JDanison/ENGT-480---Senior-Capstone/Project Notes/Danison - Semester 2 Project Notes 07.pptx

## Wabash Capstone Project Notes 07

By: John Danison

## What Did I Say I Would Do This Week?

Continue to support lab testing as requested.
Continue to develop data offloading software.

## What I Have Done Over The Past Week

Performed lab testing on Kingpin assembly and on steel cutout.
Added features to Wabash data offloading software.
Attended meetings and class.
Updated schematics and recorded Gate 5.5 presentation.

## Lab Testing – Dudley UTM Machine

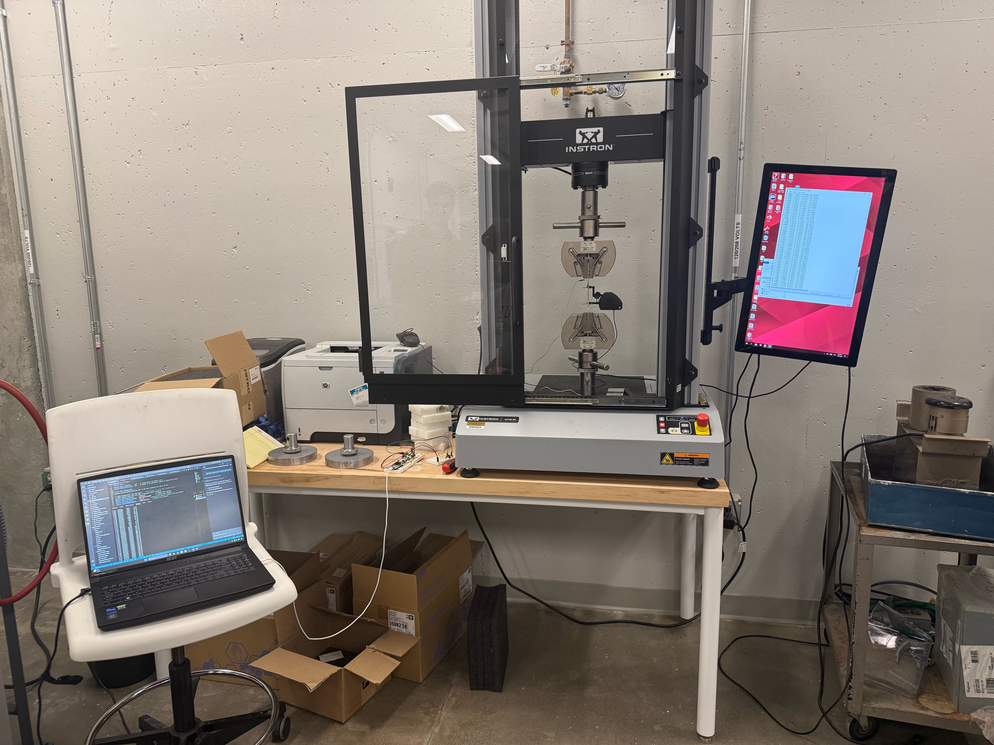
[picture p1: figure]
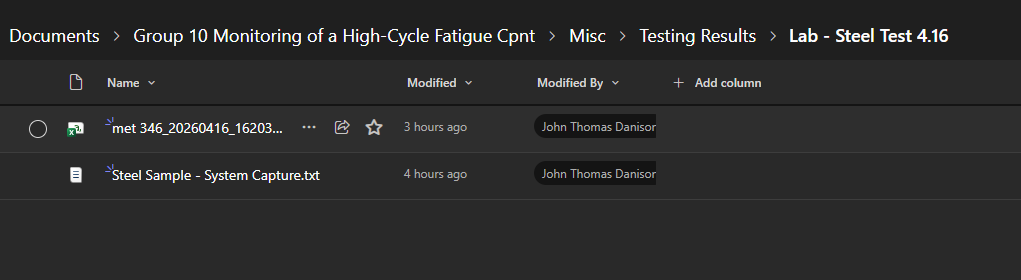
[picture p2: figure]

## Wabash Software Updates

## Slide 6

Wabash Software Updates

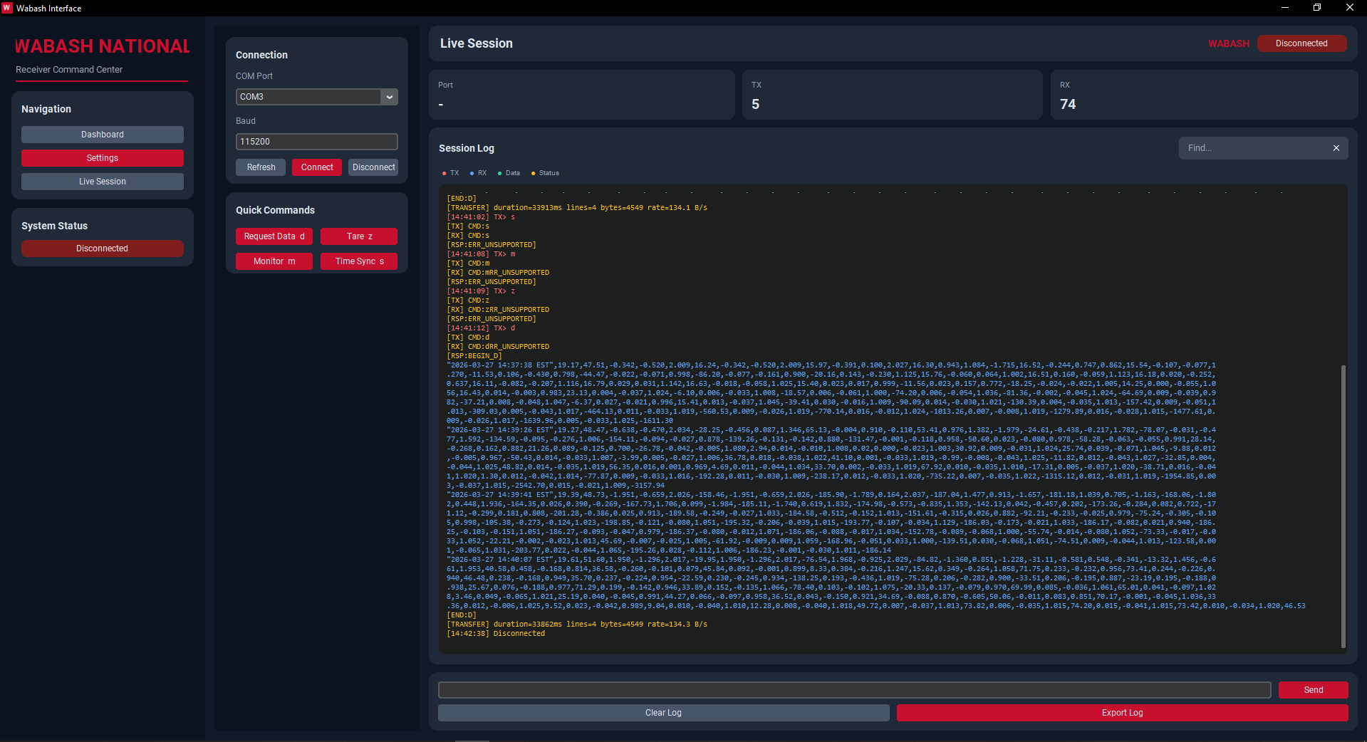
[picture p3: figure]

Initial Presentation: 3/27

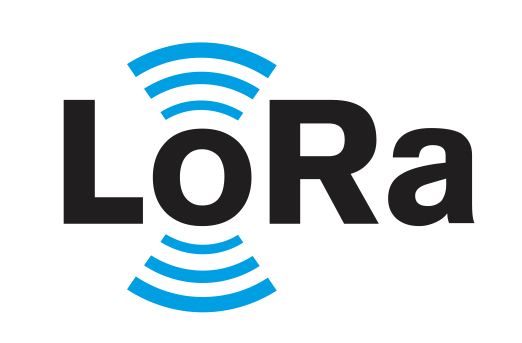
[picture p4: figure]
Lora - Key Features and Advantage |
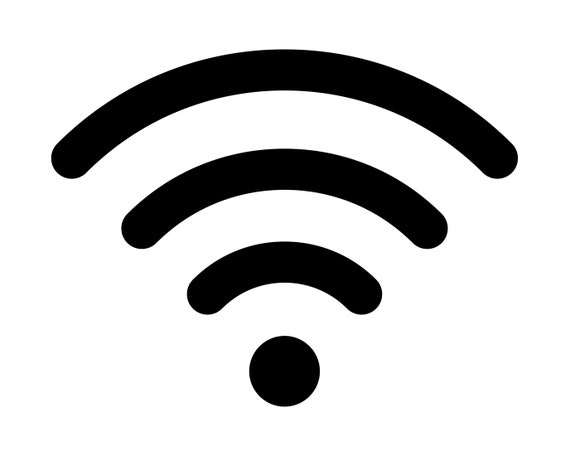
[picture p5: figure]
WiFi SVG, PNG - Wifi Clipart, Wifi Signal Svg, Wireless Internet Svg, WiFi Icon, Wi-Fi Svg, Cut File For Cricut & Silhouette
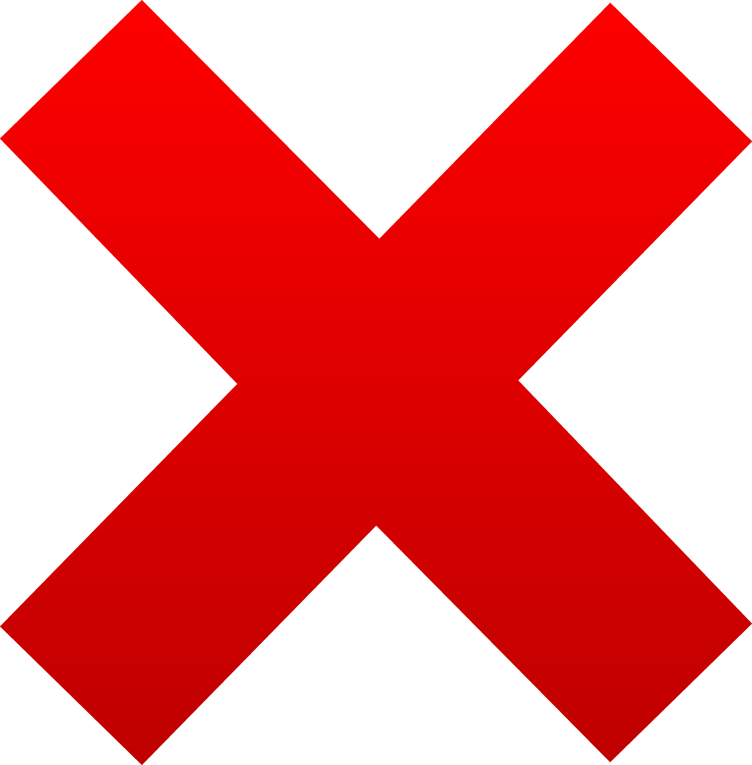
[picture p6: figure]
Simple Red X Mark Free Clip Art Clipart - Red X Mark Transparent Background - (6015x6124) Png Clipart Download

## Slide 7

Wabash Software Updates

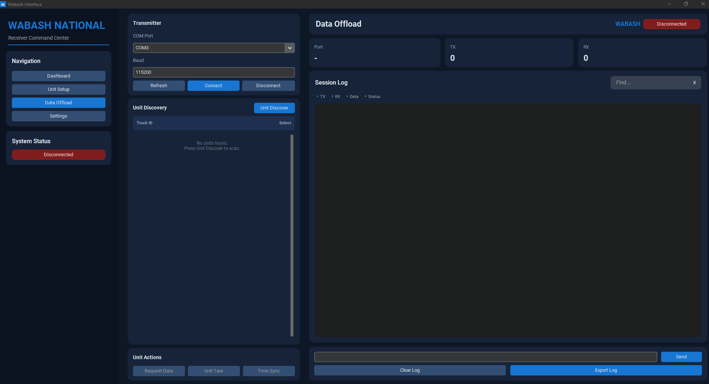
[picture p7: figure]

Presented: 4/10

## Slide 8

Wabash Software Updates

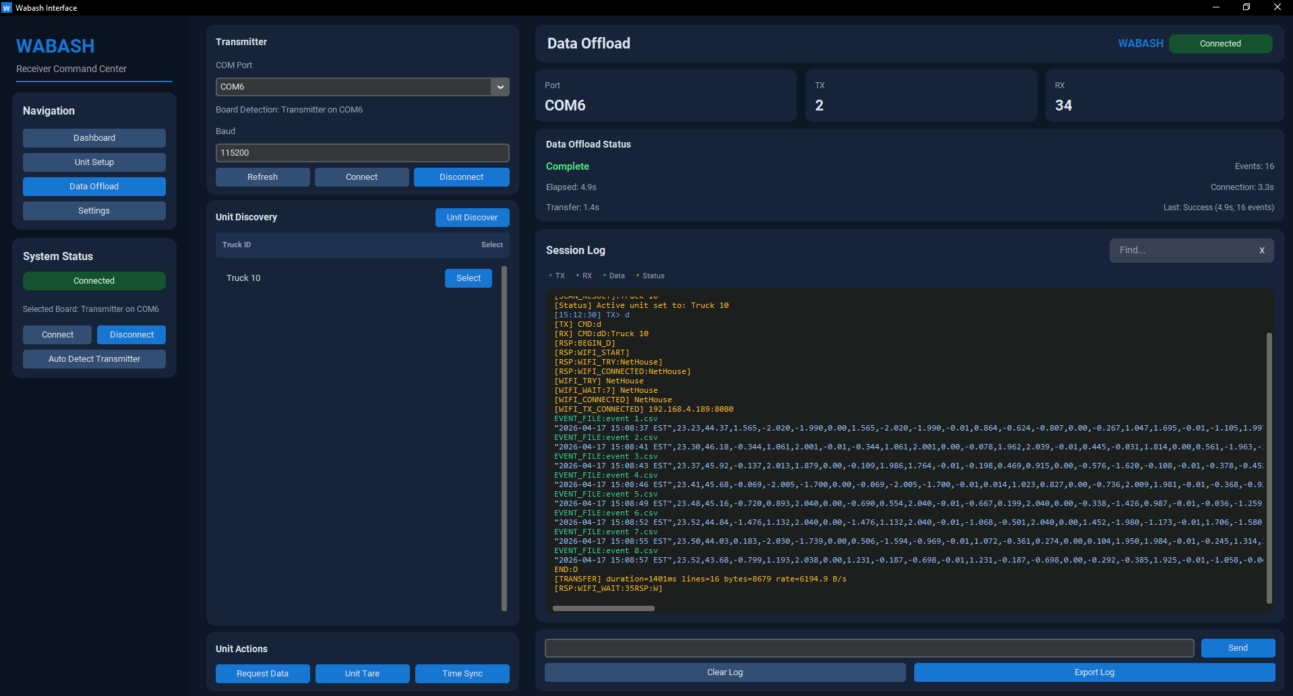
[picture p8: figure]

Current Version

## Slide 9

Wabash Software Updates

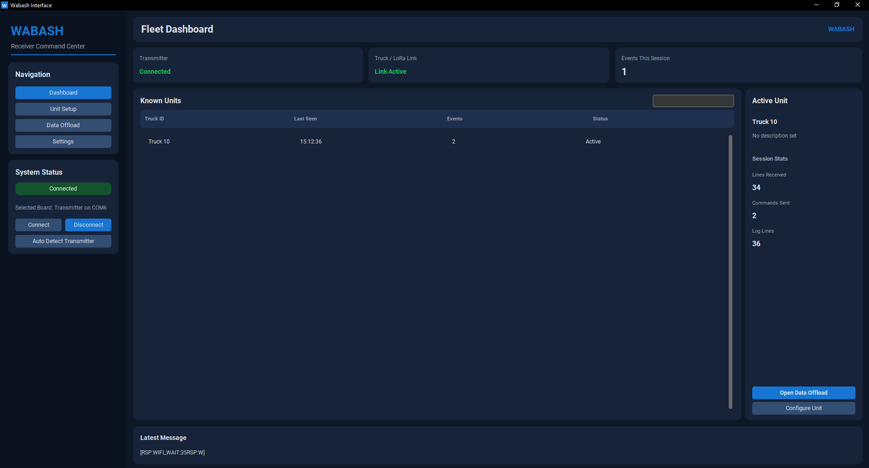
[picture p9: figure]

## Slide 10

Wabash Software Updates

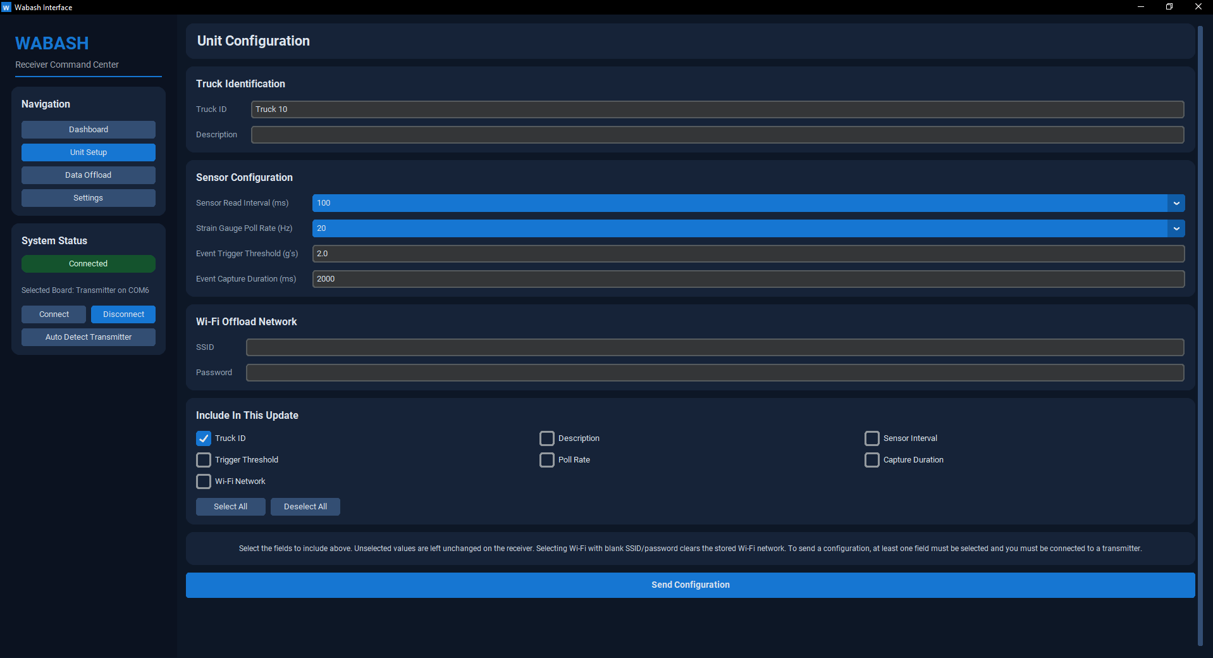
[picture p10: figure]

## Slide 11

Wabash Software Updates

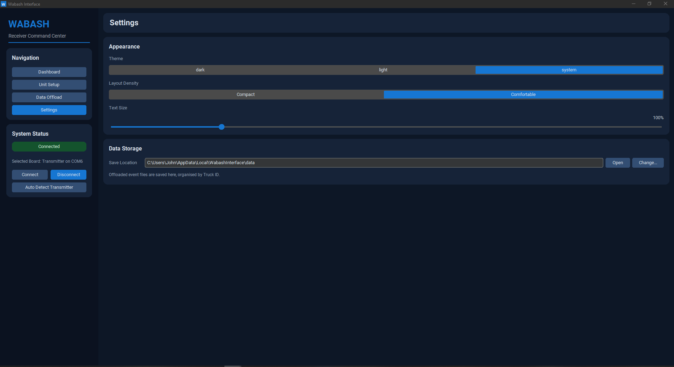
[picture p11: figure]

## Slide 12

Wabash Software Updates

SD Card Setup:

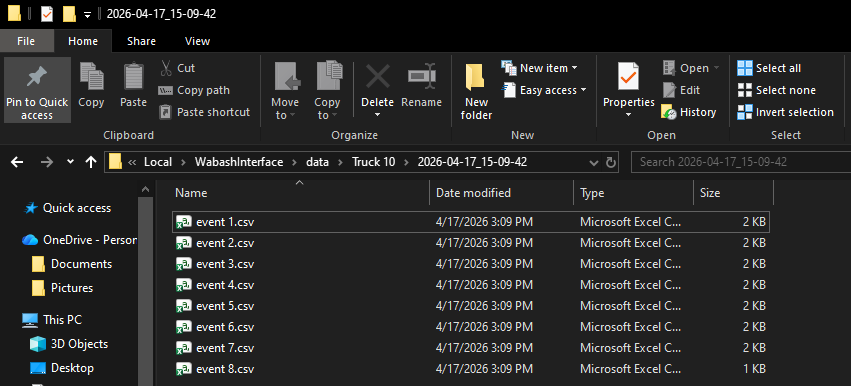
[picture p12: figure]

App Data Local Storage

## Slide 13

Wabash Software Updates

Demo Video can be found at the end of the Gate 5.5 presentation submission.
The video was giving me issues here unfortunately.

## Slide 14

Schematic Update – Added Capacitors

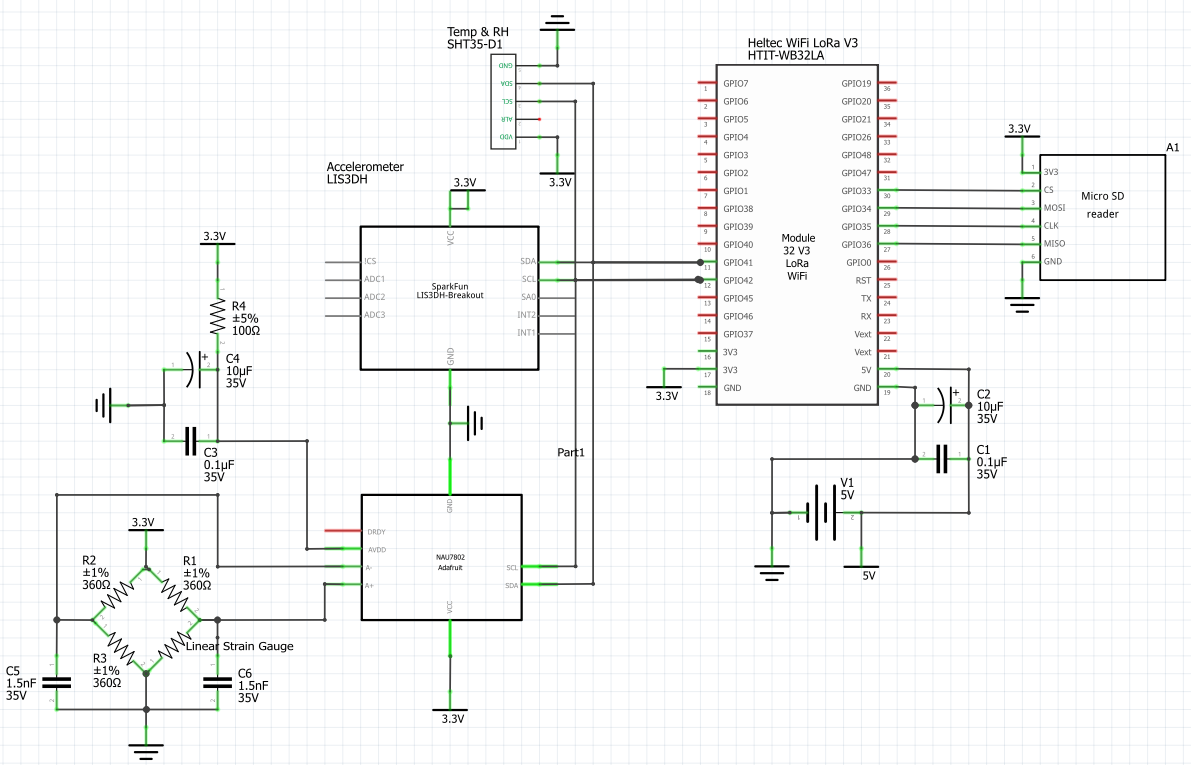
[picture p13: figure]

## Did I Do What I Say I Would Do?

I feel that I accomplished everything that I said I would do over these past couple weeks.
The data offloading software is well under development is still going well.
I attended all lectures, labs, and meetings w/ the client.

## Plans For Upcoming Weeks

High Level
By EOW:
Continue to develop data offloading software.
Continue to show up to class.
Continue to support lab testing as requested by the team.
Continue to add client feature requests in data offloading software.
