JDanison/ENGT-480---Senior-Capstone/Project Notes/Danison - Project Notes 01.pptx

## Wabash Capstone Project Notes 01

By: John Danison

## What Have I Done This Week

- Met In Person w/ Client
  - Reviewed & Gained Insight Into Project
- Reviewed What Current State-Of-The-Art Is
  - Researched patents, products, & more.
  - Wrote 2.2 in CW16
- Started Brainstorming System Sensors
- Started Brainstorming System Power

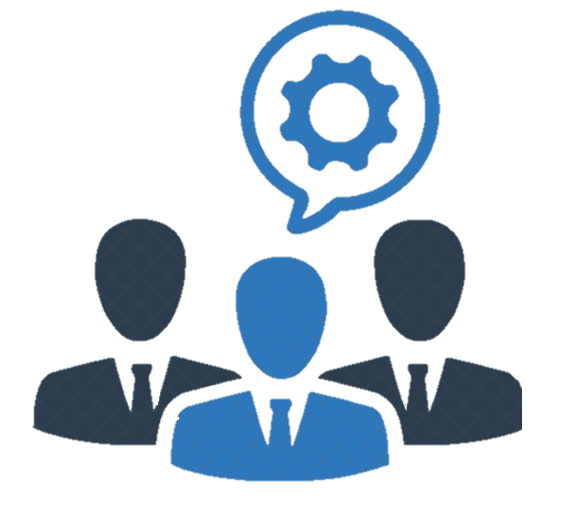
[picture p23: figure]
Technical Team Icon - Technical Team Icon - Free Transparent PNG Clipart Images Download
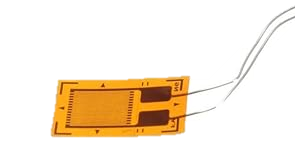
[picture p24: figure]
DAOKI 10Pcs BF350-3AA BF350 350 ohm High-Precision Pressure Resistance Strain Gauge
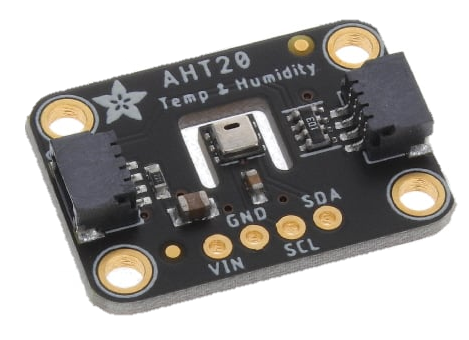
[picture p25: figure]
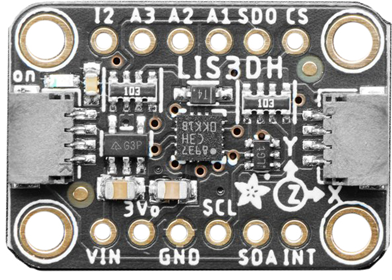
[picture p26: figure]

## Did I Do What I Say I Would Do?

Yes, I feel that I met my promises this past week. There is nothing outstanding where I am holding my group back from making progress.
I have attended every class so far.

## Plans For Upcoming Week

Continue To:
Research Existing Solutions & Define SOTA.
Brainstorm Sensors, Power Systems, & Data Acquisition Strategies
Communicate with Team Members
By EOW, Have Finalized Scope Of Work & Timeline
