JDanison/ENGT-480---Senior-Capstone/Project Notes/Danison - Project Notes 02.pptx

## Wabash Capstone Project Notes 02

By: John Danison

## What Have I Done This Week

- Met Online With Client
  - Gave updates into current SOTA
  - Summarized research conducted
- Brainstormed & Researched Microcontrollers
  - Opt 1 - Heltec WiFi LoRa v3
  - Opt 2 - ESP32-C3
  - Opt 3 - nRF52840
- Wrote Technical Report in CW 18

Technical Team Icon - Technical Team Icon - Free Transparent PNG Clipart Images Download
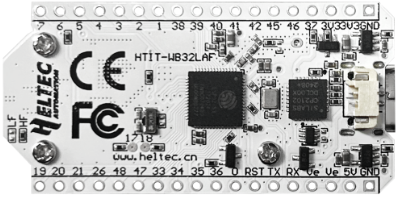
[picture p27: figure]
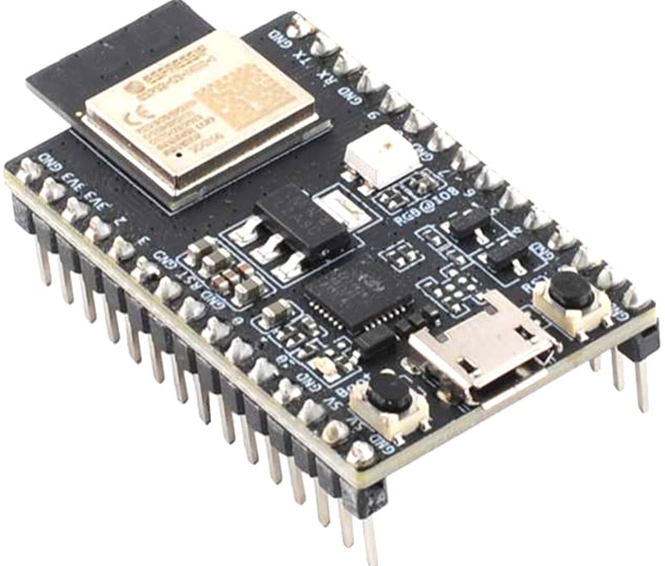
[picture p28: figure]
Amazon.com: ESP32-C3-DevKitM-1 ESP32 C3 Development Board ESP32-C3-MINI-1 WiFi+BT BLE Module ESP32-C3FN4 Core 4MB Flash for Arduino : Electronics
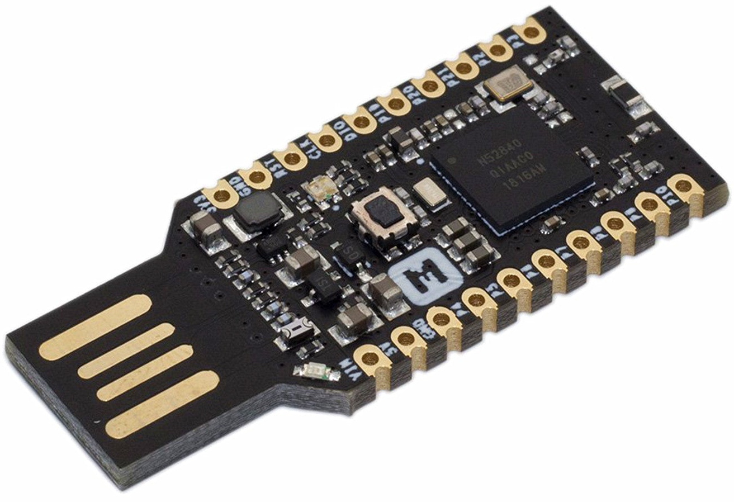
[picture p29: figure]

## Did I Do What I Say I Would Do?

Yes, I feel that I met my promises this past week. There is nothing outstanding where I am holding my group back from making progress.
I have attended every class so far. I lead the team in technical solution brainstorming.

## Plans For Upcoming Week

Continue To:
Continue to Brainstorm Sensors, Power Systems, & Data Acquisition Strategies
Communicate with Team Members
By EOW:
Work on Gate Report
Continue To Research / Become Expert On Trailer Couplers & Kingpins
