JDanison/ENGT-480---Senior-Capstone/Project Notes/Danison - Project Notes 03.pptx

## Wabash Capstone Project Notes 03

By: John Danison

## What Have I Done This Week

- Researched further into Kingpin & Couplers
- Scheduled a Time to Meet For GR1.5
- Wrote Gate Report 1

Technical Team Icon - Technical Team Icon - Free Transparent PNG Clipart Images Download
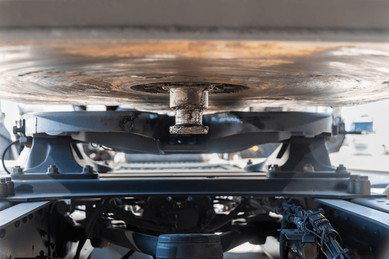
[picture p30: figure]
Close-up Trailer Kingpin Fifth Wheel Coupling Stock Photo 2614683175 | Shutterstock
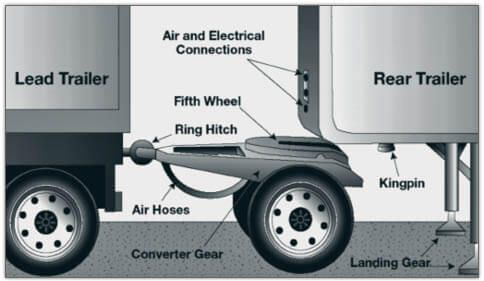
[picture p31: figure]
Coupling/Uncoupling

## Did I Do What I Say I Would Do?

Yes, I feel that I met my promises this past week. There is nothing outstanding where I am holding my group back from making progress.
I have attended every class so far. I continue to lead the EE & DAQ of this project.

## Plans For Upcoming Week

Continue To:
Refine Sensors, Power Systems, & Data Acquisition Strategies
Communicate with Team Members
By EOW:
Present GR1.5
Acquire More Information From Wabash
