JDanison/ENGT-480---Senior-Capstone/Project Notes/Danison - Project Notes 05.pptx

## Wabash Capstone Project Notes 05

By: John Danison

## What Have I Done This Week

- Researched Potential Sensor Options
- Selected Sensors, Microcontroller, & Storage
- Started Drafting Data Acquisition Solutions
  - Duration (Burst or Constant)
  - How Data Is Stored & How Often

Technical Team Icon - Technical Team Icon - Free Transparent PNG Clipart Images Download

## Did I Do What I Say I Would Do?

As usual, I feel that I met my promises this past week.
There is nothing outstanding where I am holding my group back from making progress.
I have attended every class so far. I continue to lead the EE & DAQ of this project.

## Plans For Upcoming Week

Continue To:
Refine Data Acquisition Strategy | Specifically How Data Will Be Formatted
Communicate with Team Members
By EOW:
Have Sensors Picked & Documentation For Reasons Complete
