JDanison/ENGT-480---Senior-Capstone/Project Notes/Danison - Semester 2 Project Notes 06.pdf

# Wabash Capstone Project Notes 06

## By: John Danison

# What Did I Say I Would Do This Week?

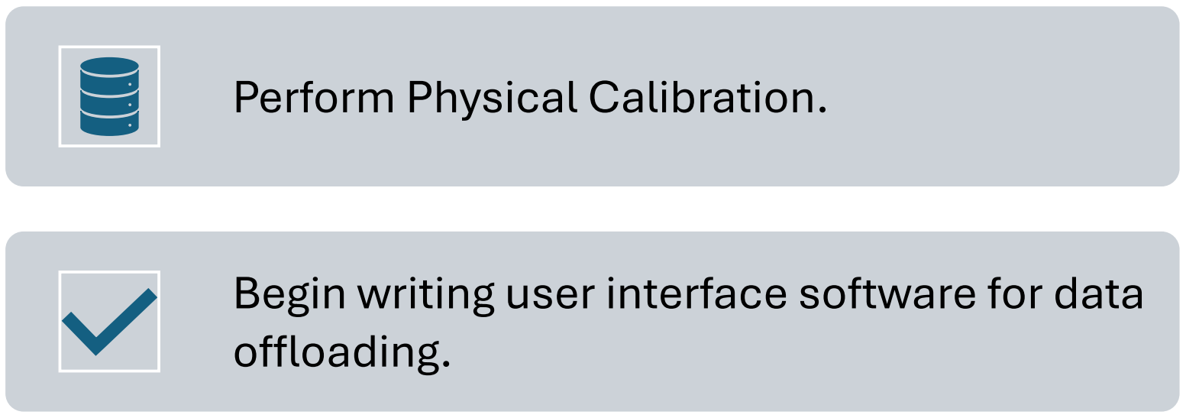
[picture p43: figure]
Perform Physical Calibration.; offloading.

## Begin writing user interface software for data

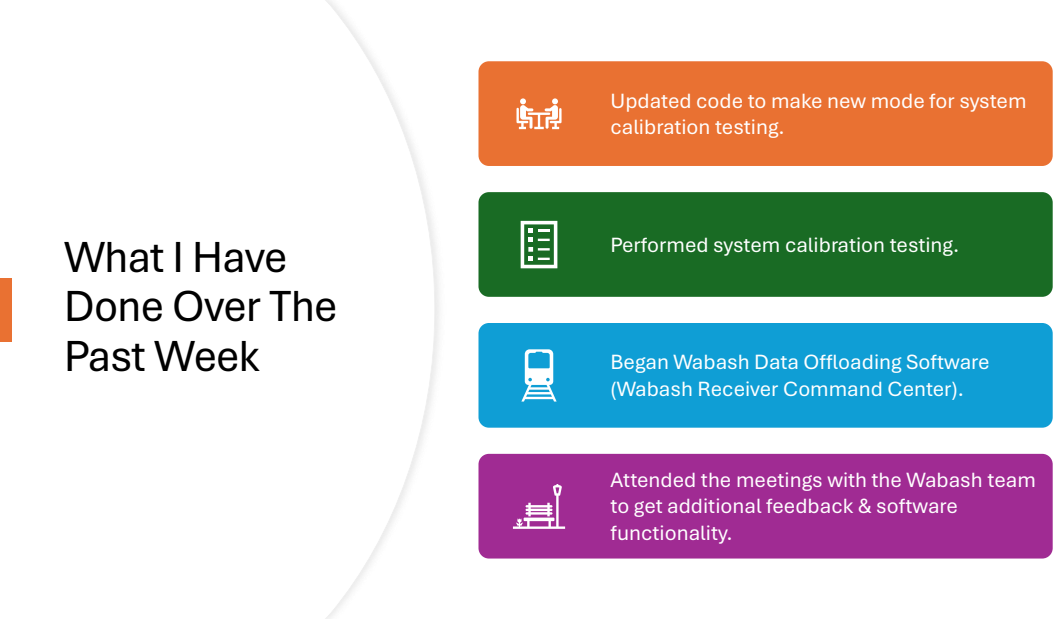
[picture p44: page 3]

Updated code to make new mode for system
calibration testing.

What I Have
Done Over The
Past Week

Performed system calibration testing.

Began Wabash Data Offloading Software
(Wabash Receiver Command Center).

Attended the meetings with the Wabash team
to get additional feedback & software
functionality.

# Updated Code w/ New Mode

4/10/2026 4

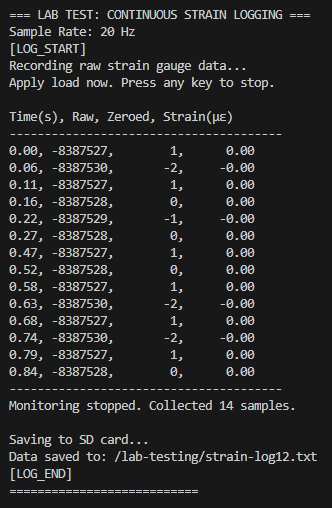
[picture p45: figure]

I made another line option “L” to allow for continuous data capture and then to write this to the SD card.

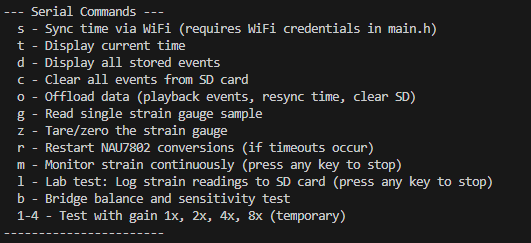
[picture p46: figure]

# Calibration Testing - Setup

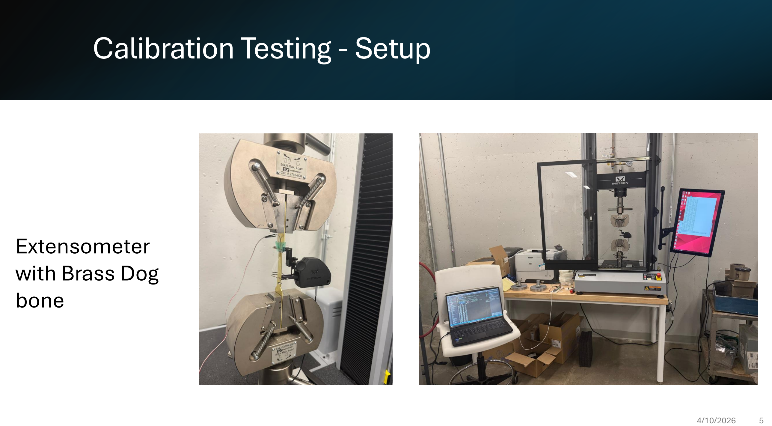
[picture p47: page 5]

## Extensometer with Brass Dog bone

# Calibration Testing - Results

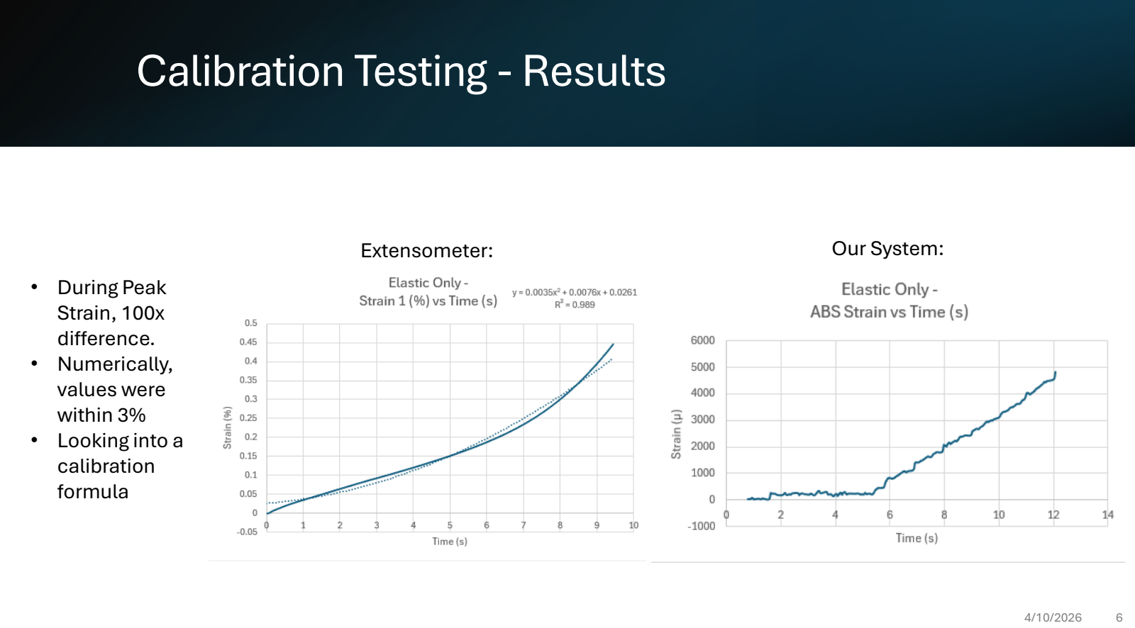
[picture p48: page 6]

Extensometer: | Our System:
- During Peak
Strain, 100x
difference.
- Numerically,
values were
within 3%
- Looking into a
calibration
formula

# Wabash Data Offloading Software

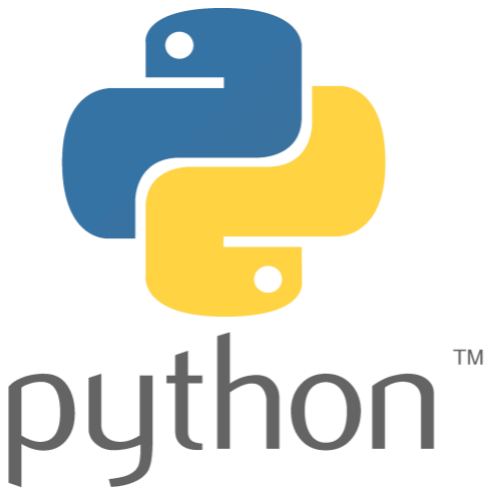
[picture p49: figure]

- customtkinter (main desktop UI framework)
- pyserial (serial communication with hardware)
- pillow (image handling for the UI/assets)
- pyinstaller (packaging the app into an executable)
- setuptools (build/packaging backend)
- wheel (build artifact support)

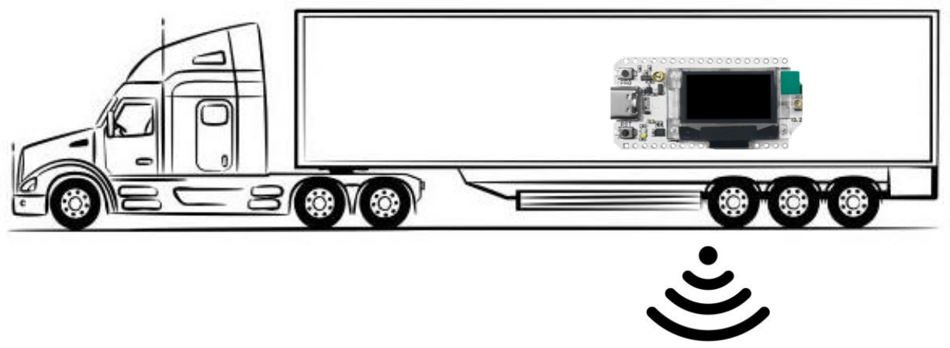
[picture p50: figure]
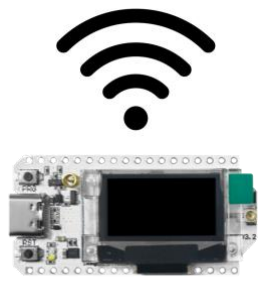
[picture p51: figure]
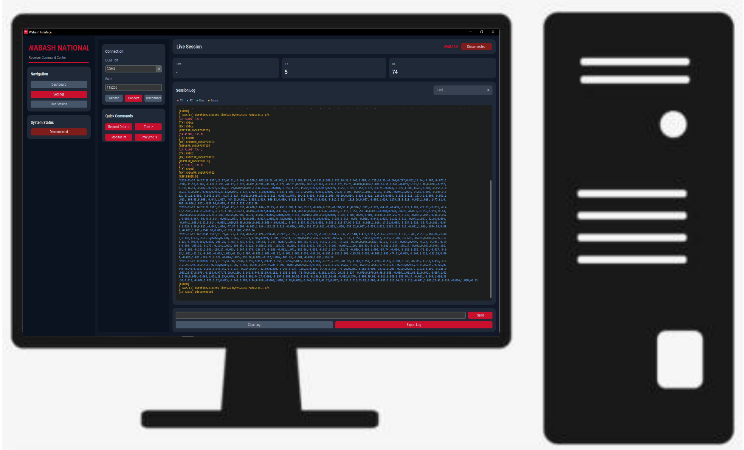
[picture p52: figure]

# Wabash Data Offloading Software - Old

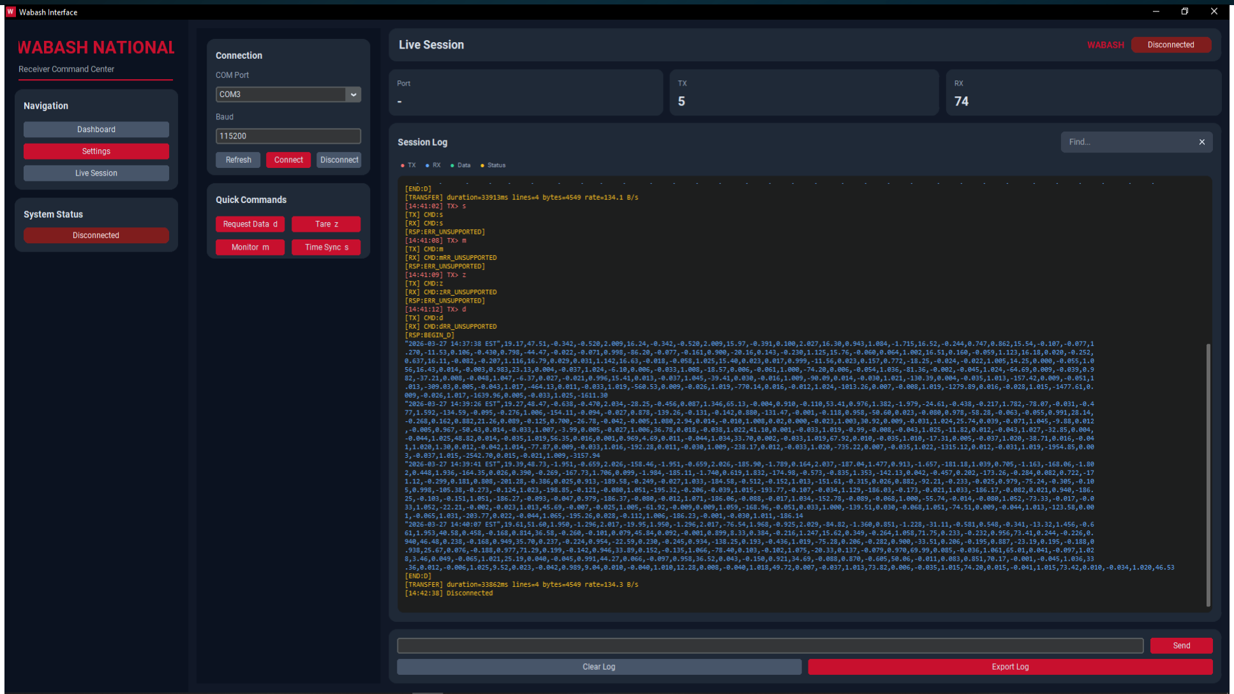
[picture p53: figure]

# Wabash Data Offloading Software - Current

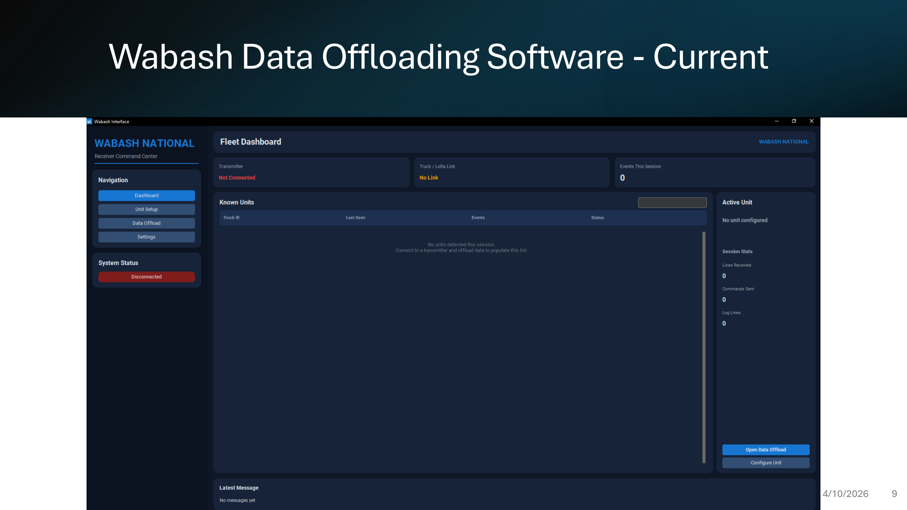
[picture p54: page 9]

# Wabash Data Offloading Software - Current

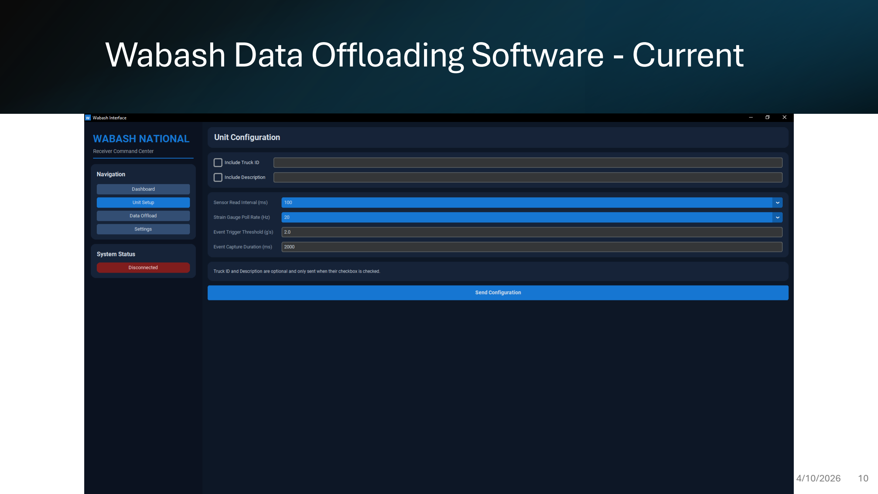
[picture p55: page 10]

# Wabash Data Offloading Software - Current

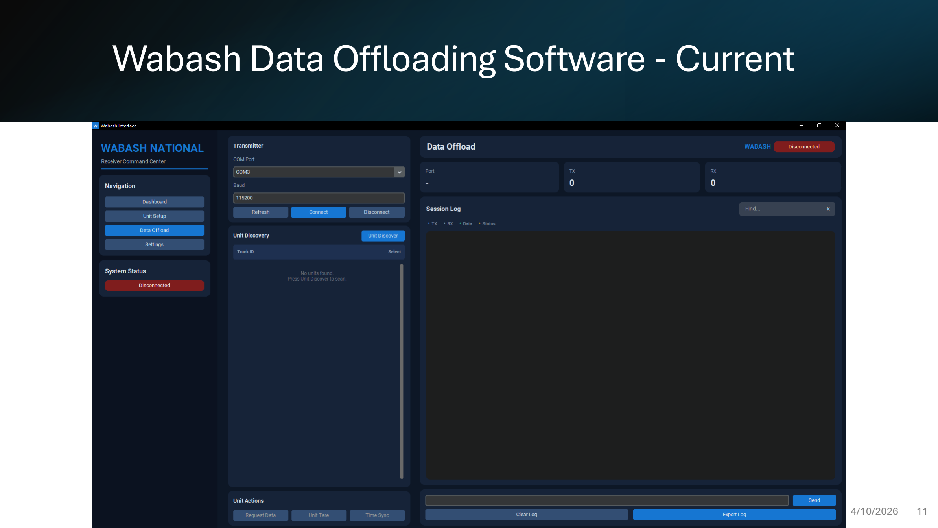
[picture p56: page 11]

# Wabash Data Offloading Software - Current

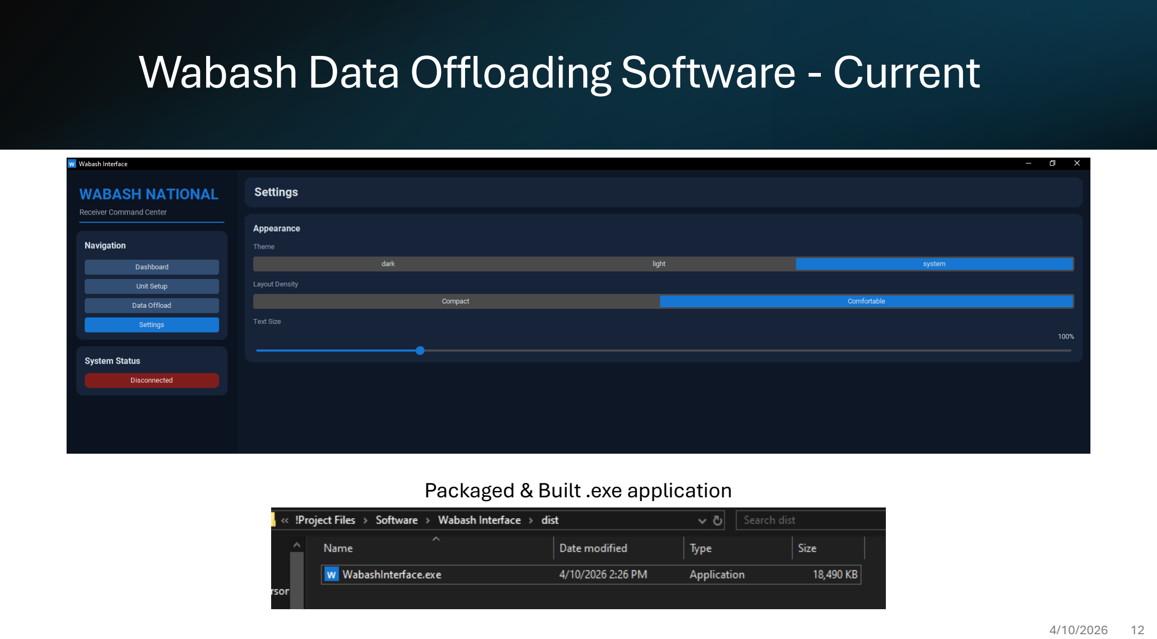
[picture p57: page 12]

Packaged & Built .exe application

# Did I Do What I Say I Would Do?

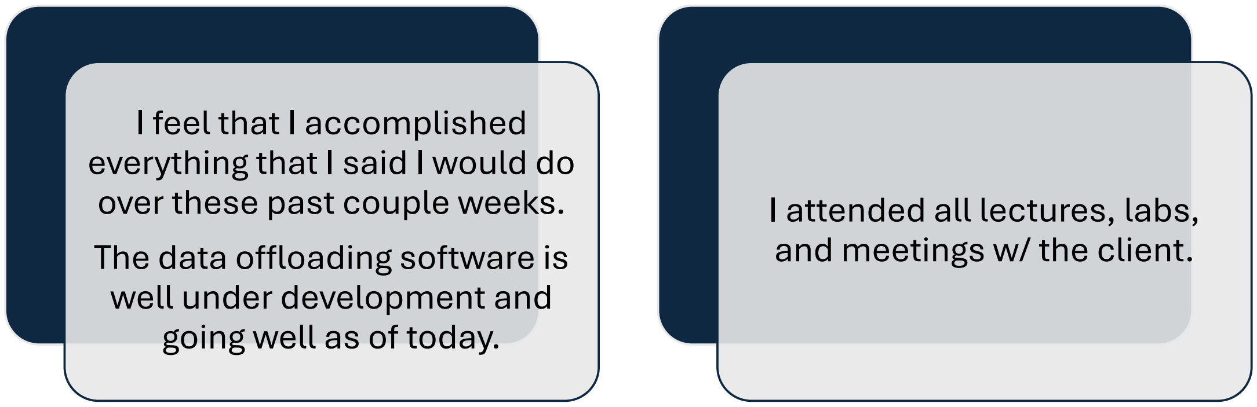
[picture p58: figure]
I feel that I accomplished everything that I said I would do over these past couple weeks. The data offloading software is well under development and going well as of today.; I attended all lectures, labs, and meetings w/ the client.

# Plans For Upcoming Weeks

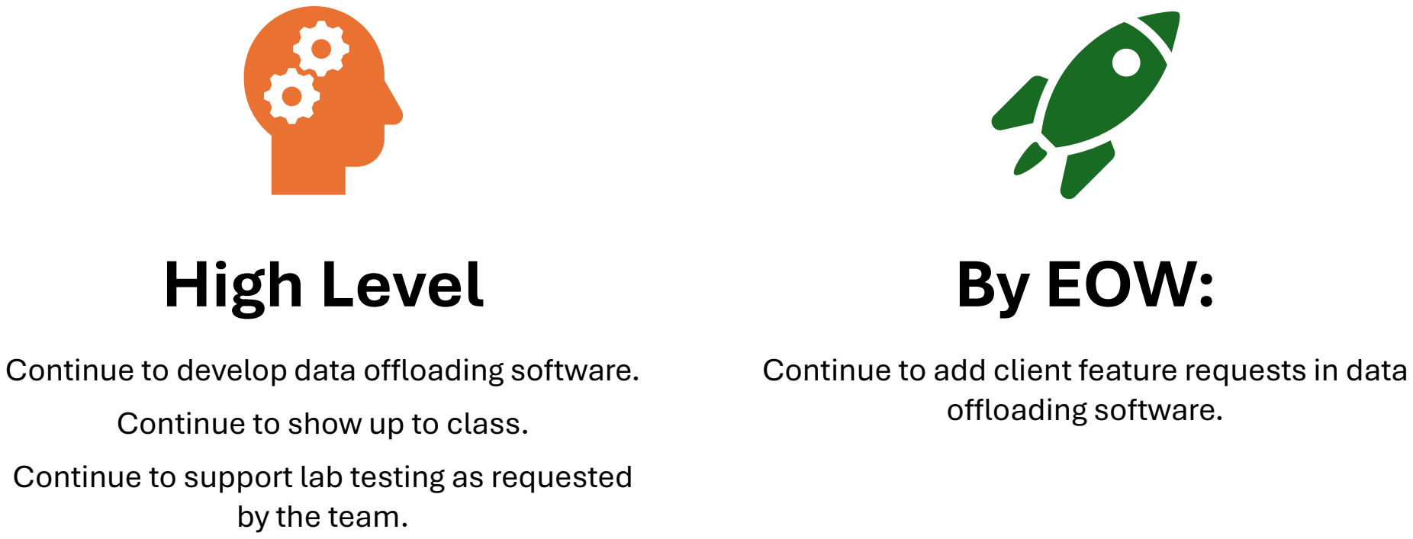
[picture p59: figure]
High Level; Continue to show up to class.; by the team.; By EOW:; offloading software.

Continue to develop data offloading software.

Continue to support lab testing as requested

Continue to add client feature requests in data
