JDanison/ENGT-480---Senior-Capstone/Project Notes/Danison - Semester 2 Project Notes 05.pdf

# Wabash Capstone Project Notes 05

## By: John Danison

# What Did I Say I Would Do This Week?

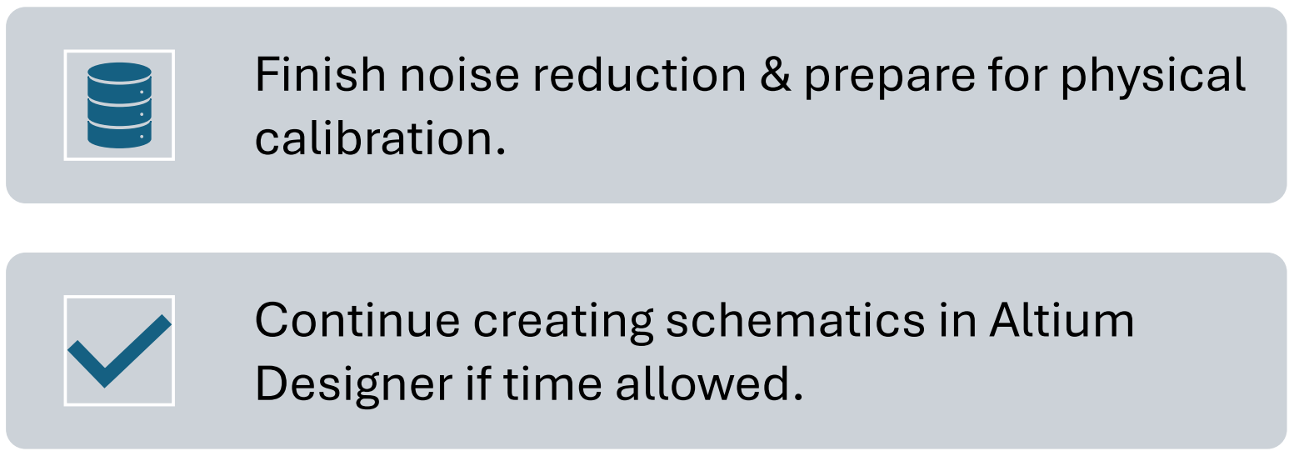
[picture p60: figure]
calibration.; Continue creating schematics in Altium Designer if time allowed.

## Finish noise reduction & prepare for physical

# What I Have

# Done Over The Past Week

Finished the noise reduction for the time being. I am as prepared as I can be for the physical calibration testing.

Began attempting to integrate new temperature sensor into system.

Produced new system demonstration for the Gate Report 4.5

Attended the meeting with the Wabash team. Starting planning and mapping out wireless data transfer process. Using Wabash feedback for their wishes.

# Video Demo

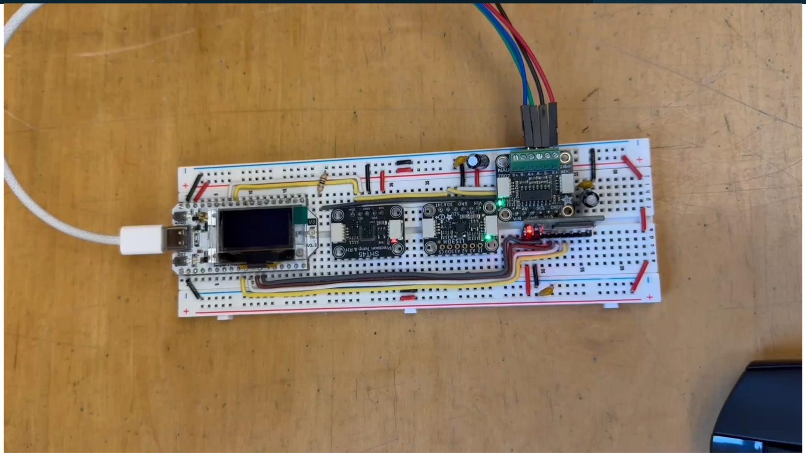
[picture p61: figure]

# Did I Do What I Say I Would Do?

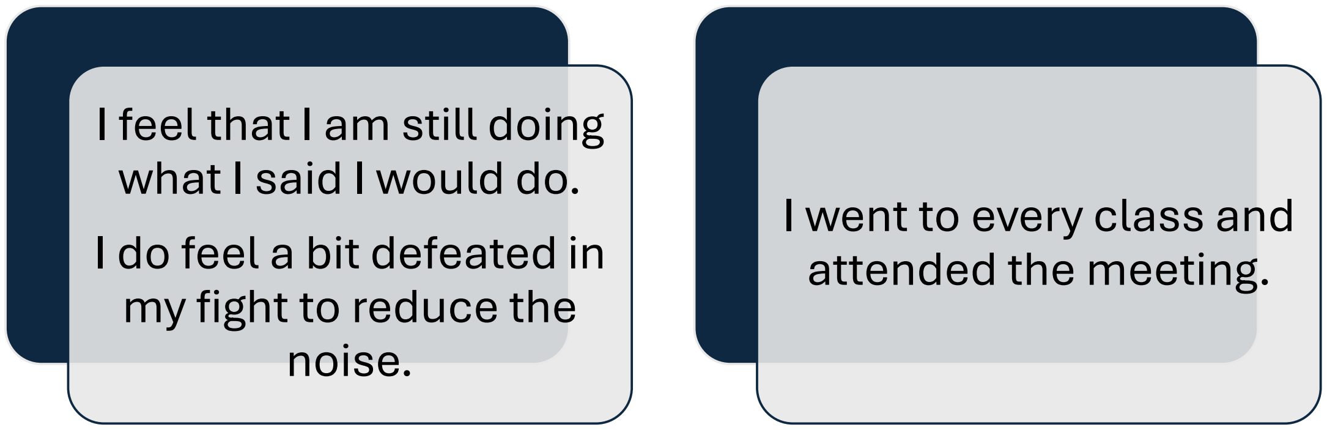
[picture p62: figure]
I feel that I am still doing what I said I would do. I do feel a bit defeated in my fight to reduce the noise.; I went to every class and attended the meeting.

# Plans For Upcoming Weeks

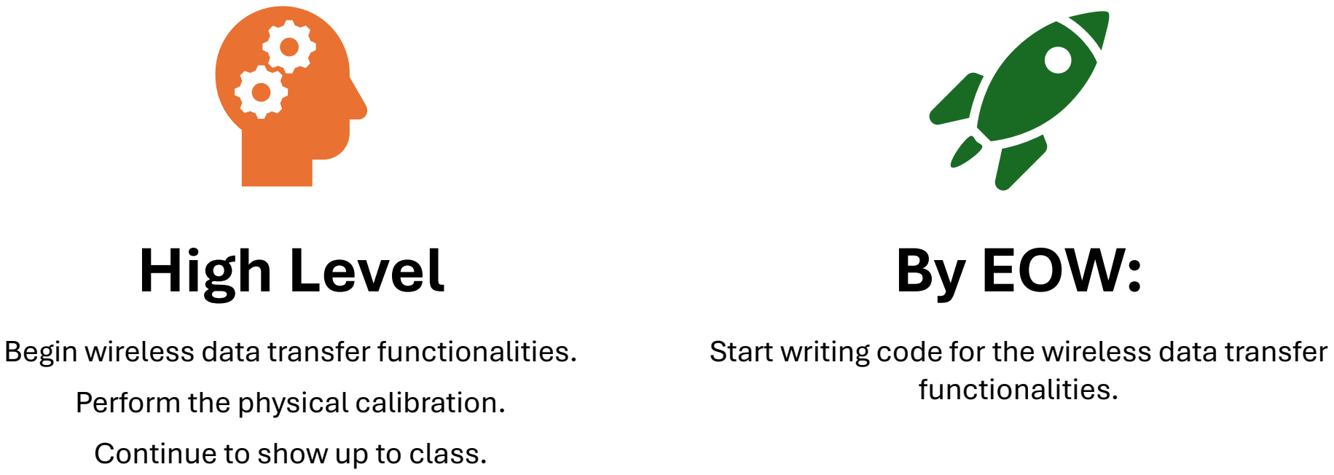
[picture p63: figure]
High Level; Begin wireless data transfer functionalities. Perform the physical calibration. Continue to show up to class.; By EOW:; functionalities.

Start writing code for the wireless data transfer
