JDanison/ENGT-480---Senior-Capstone/Project Notes/Danison - Project Notes 04.pdf

# Wabash Capstone Project Notes 04

By: John Danison

## What Have I Done This Week

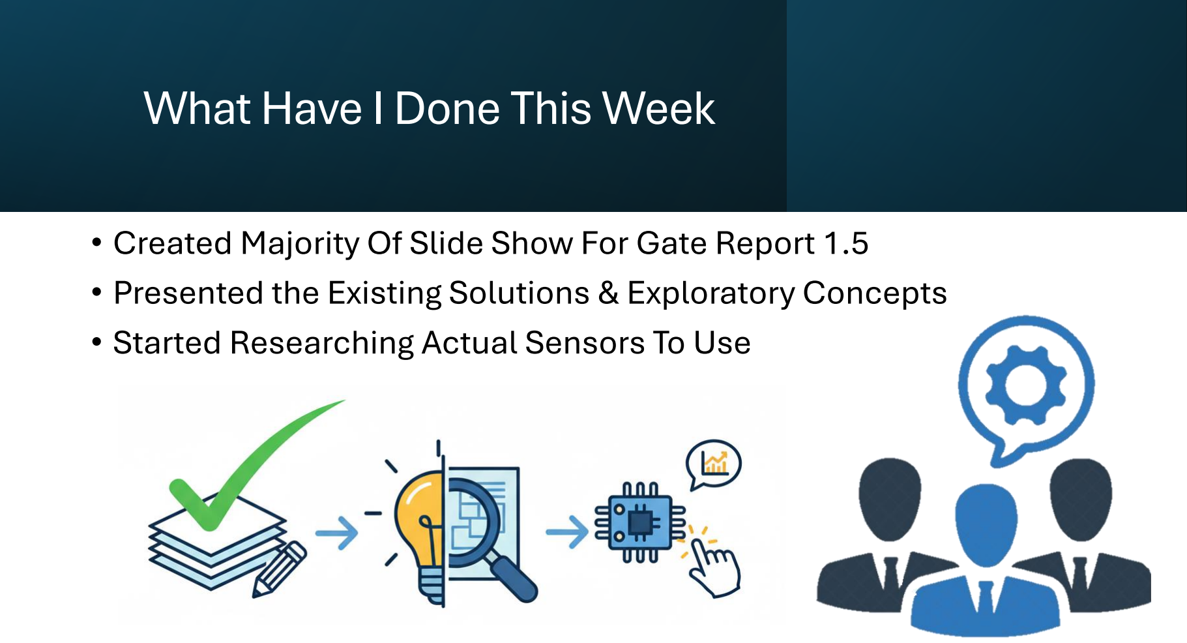
[picture p74: page 2]

- Created Majority Of Slide Show For Gate Report 1.5
- Presented the Existing Solutions & Exploratory Concepts
- Started Researching Actual Sensors To Use

## Did I Do What I Say I Would Do?

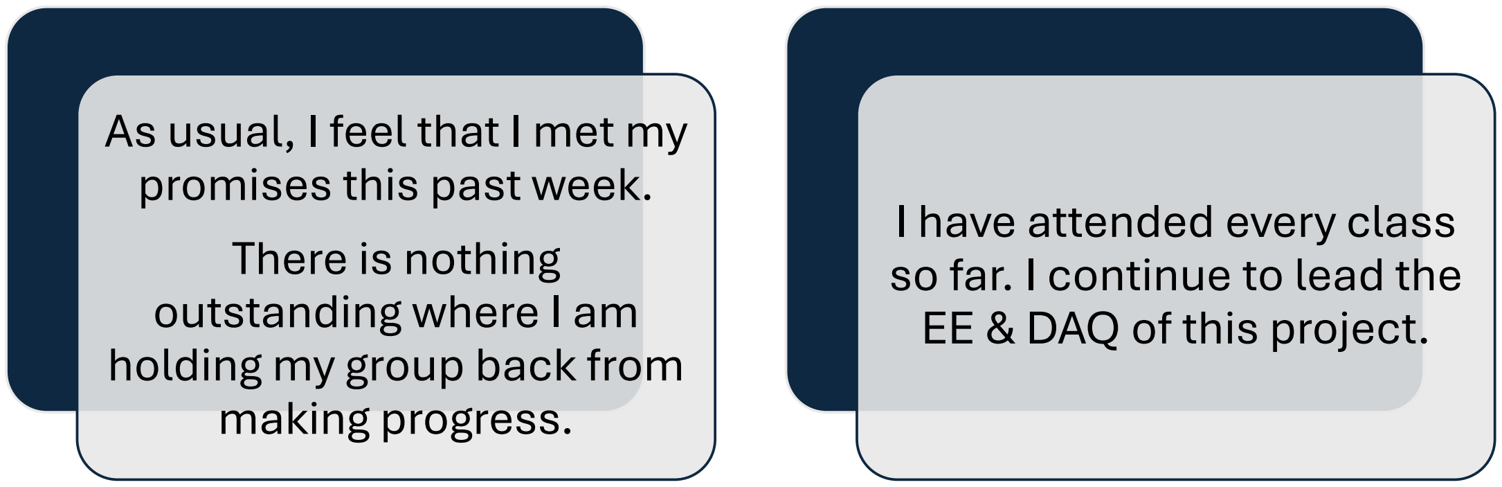
[picture p75: figure]
As usual, I feel that I met my promises this past week. There is nothing outstanding where I am holding my group back from making progress.; I have attended every class so far. I continue to lead the EE & DAQ of this project.

## Plans For Upcoming Week

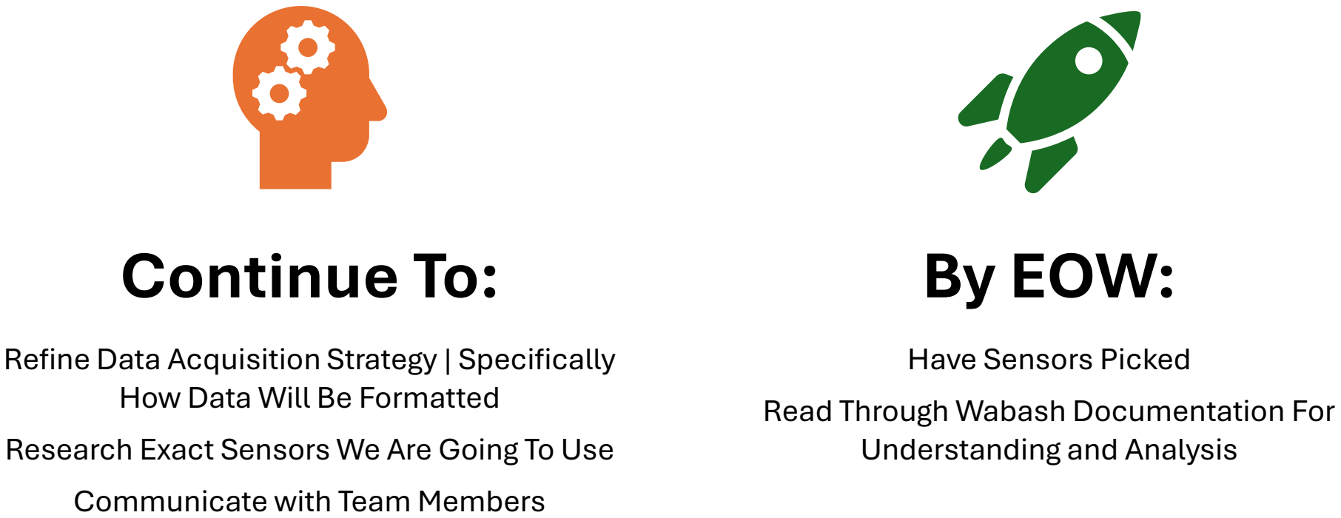
[picture p76: figure]
Continue To:; How Data Will Be Formatted; Communicate with Team Members; By EOW:; Have Sensors Picked Read Through Wabash Documentation For Understanding and Analysis

Refine Data Acquisition Strategy | Specifically

Research Exact Sensors We Are Going To Use
