JDanison/ENGT-480---Senior-Capstone/Project Notes/Danison - Semester 2 Project Notes 08.pptx

## Wabash Capstone Project Notes 08

By: John Danison

## What Did I Say I Would Do This Week?

Continue to support lab testing as requested.
Continue to develop data offloading software.

## What I Have Done Over The Past Week

Performed lab testing on Kingpin assembly.
Added features to Wabash data offloading software.
Attended meetings and class.
Contributed to Capstone Poster.

## Slide 4

Wabash Lab Testing

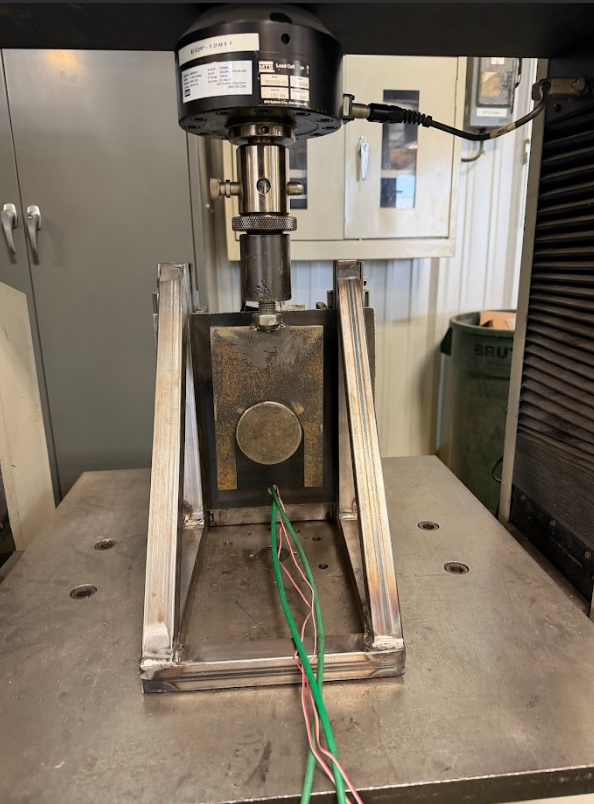
[picture p77: figure]

Went to Wabash:
- Attached system to their rig
- Gathered data
- Troubleshot issues
- Showed offloading software

## Slide 5

Wabash Software Updates

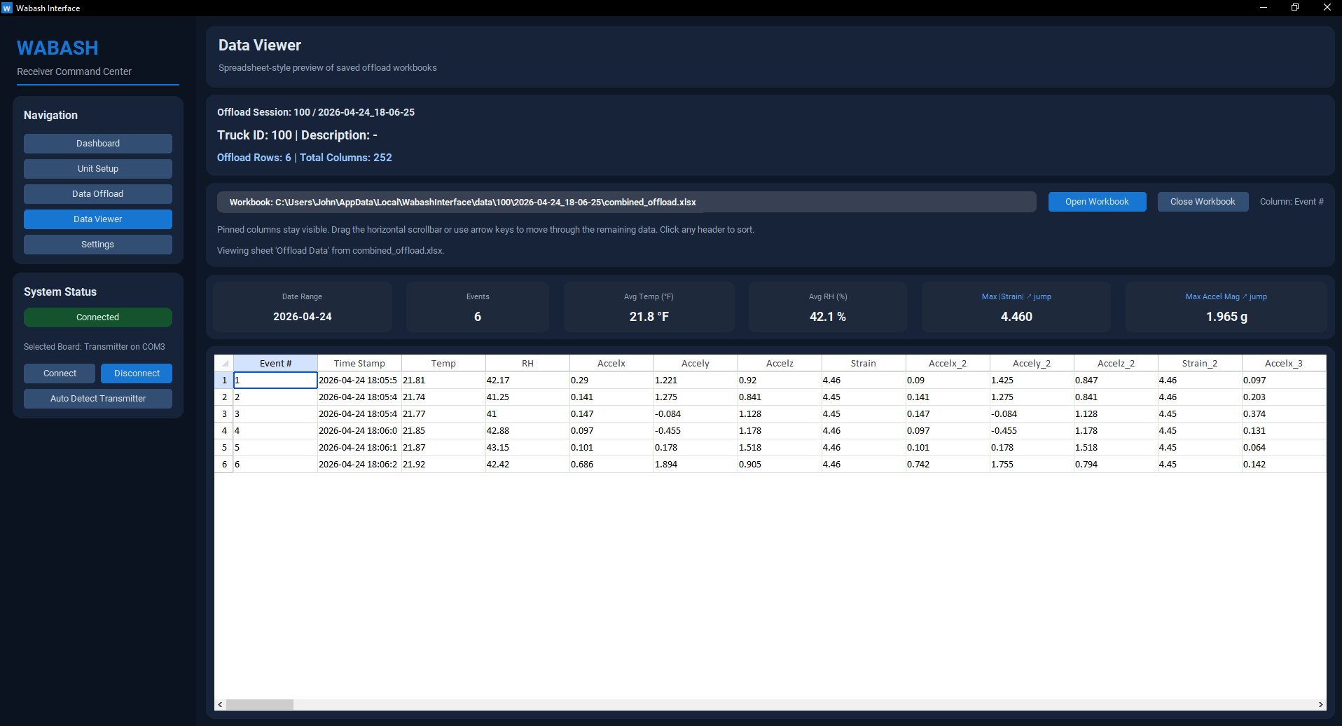
[picture p78: figure]

Software Changes:
- Added data viewer screen
- Fixed offloaded data configuration
- Fixed LoRa fall back & Multiple Wi-Fi configuration setup

## Slide 6

Wabash Software Updates

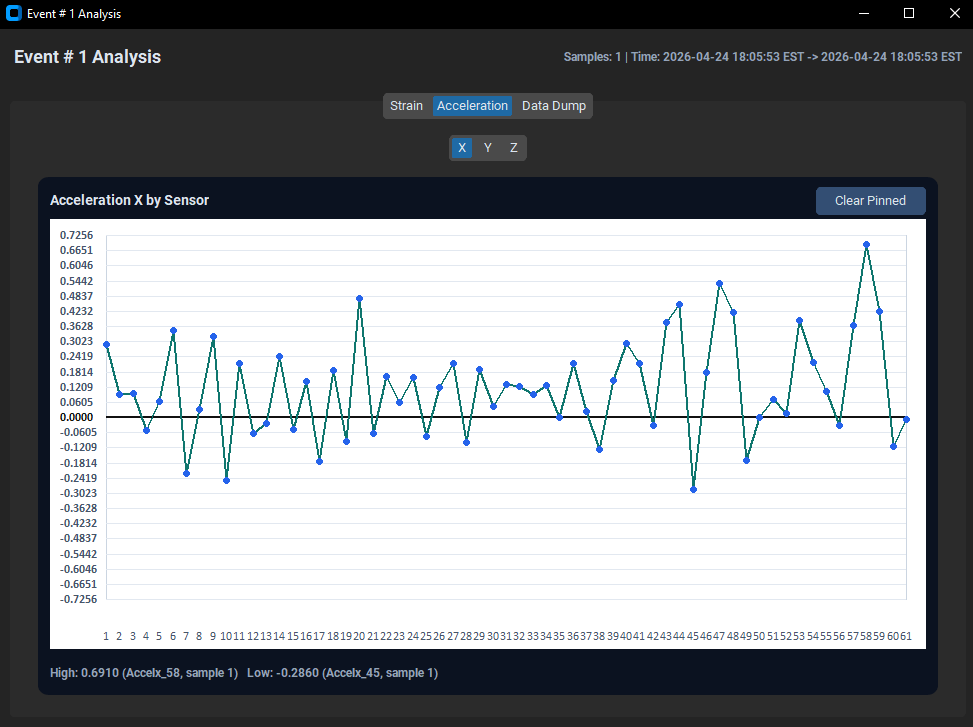
[picture p79: figure]

Software Changes:
- Added data viewer screen
- Fixed offloaded data configuration
- Fixed LoRa fall back & Multiple Wi-Fi configuration setup

## Did I Do What I Say I Would Do?

I feel that I accomplished everything that I said I would do over these past couple weeks.
The data offloading software is practically finished!
I attended all lectures, labs, and meetings w/ the client.

## Plans For Upcoming Weeks

High Level
By EOW:
Continue to develop data offloading software.
Continue to show up to class.
Continue to support lab testing as requested by the team.
Continue to add client feature requests in data offloading software.
Send compiled .exe to Luke
