JDanison/ENGT-480---Senior-Capstone/!Project Files/Hardware/Simple Circuit Schematic.pdf

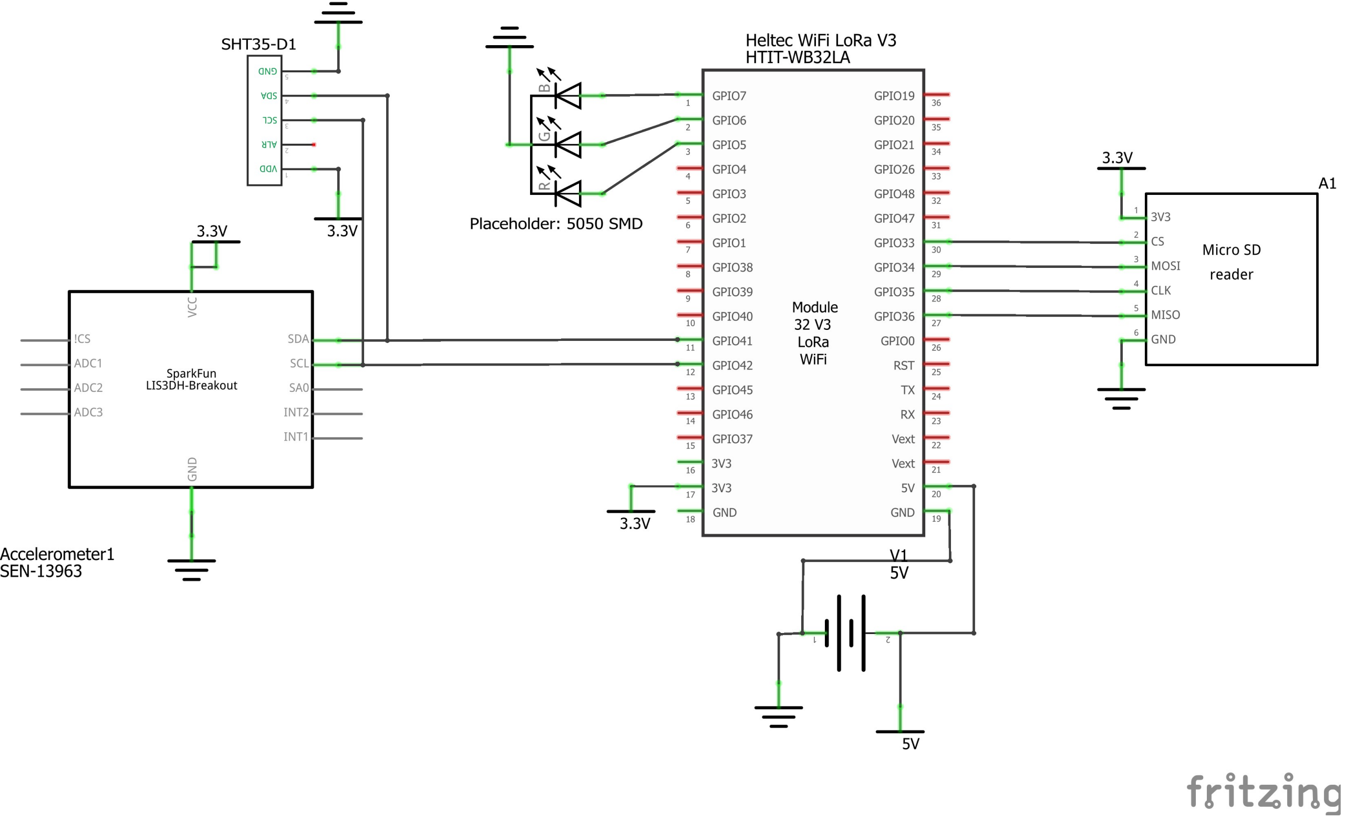
[picture p80: figure]
