JDanison/ENGT-480---Senior-Capstone/Course Work/Danison - CG04.pdf

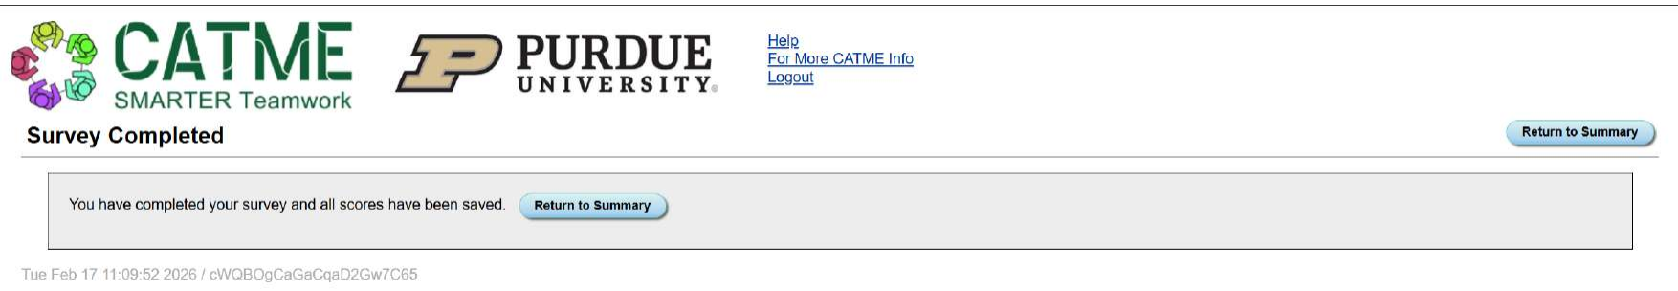
[picture p81: figure]
