JDanison/ENGT-480---Senior-Capstone/Course Work/Catme Round 1 Completed.JPG

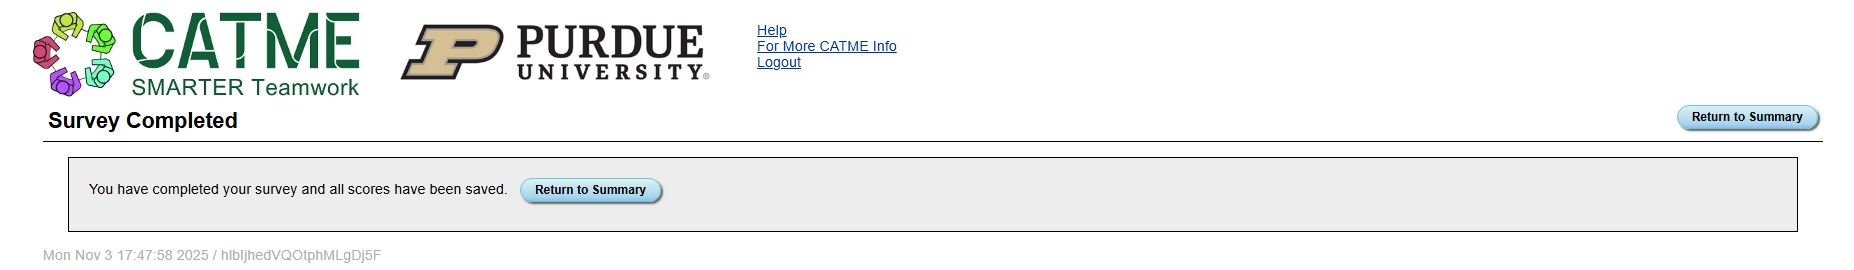
Course Work/Catme Round 1 Completed.JPG
