JDanison/ENGT-480---Senior-Capstone/Course Work/CG04.png

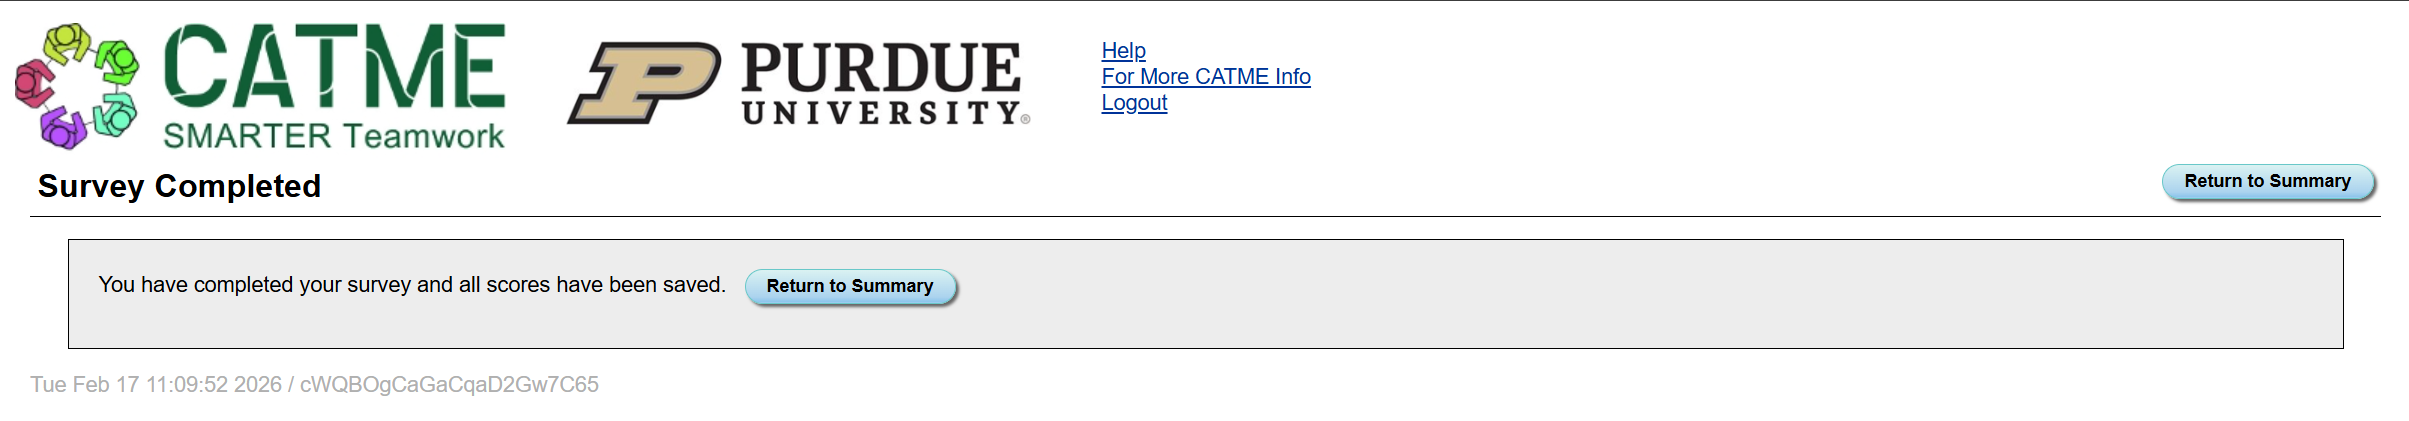
Course Work/CG04.png
