JDanison/ENGT-480---Senior-Capstone/Course Work/CW22.JPG

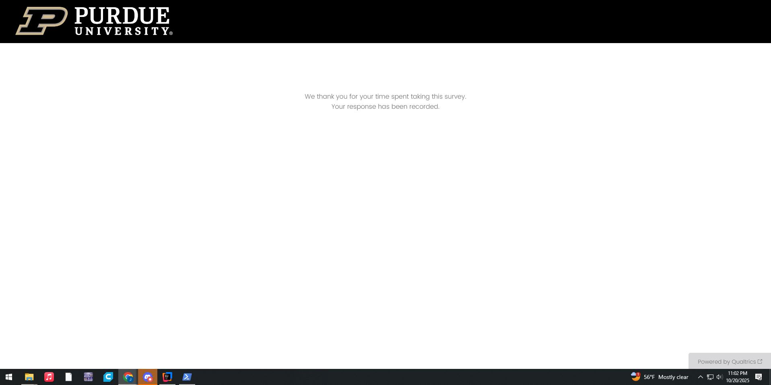
Course Work/CW22.JPG
