JDanison/ENGT-480---Senior-Capstone/Course Work/2025_Rubric_Gates 1-6 (1).xlsx

Sheet: G1R
Gate 1 Technical Report Rubric
Category | Report Sec.# | Title | Requirements (Additional information provided in Guidelines_Report.doc) | Meets Expectations (12) | (11) | (10) | (9) | (8) | (7) | (6) | (5) | (4) | (3) | (2) | (1) | No Evidence (0) | Score (0-12) | Avg. Score | Comments
Front Matter | i | Cover Page and Table of Contents | Professional representation of the project. Gate Report sections listed (e.g., body, references, and appendices) with correct page numbers. Updated and/or impacted sections highlighted in red. | x |  |  |  |  |  |  |  |  |  |  |  |  | 12 | 12
 | ii | Executive Summary | Concise summary of the current accomplishments and the future expectations for the next Gate Report. Updated at every Gate Report. | x |  |  |  |  |  |  |  |  |  |  |  |  | 12
Project Definition | 1.1 | Problem Description | Includes context to the problem, reason for the problem, need for this project, defines who is impacted by the problem (customer / market) and how. | x |  |  |  |  |  |  |  |  |  |  |  |  | 12 | 12
 | 1.2 | Problem Statement | Describes the problem in technical detail and Quantifies the impact on the customer/market. Introduce critical performance metrics. Defines the end-user population (e.g., person, environment, or organization). | x |  |  |  |  |  |  |  |  |  |  |  |  | 12
 | 1.3 | Scope of Work | Describes the approach to solve this problem, the projected timeline plan, and the assumptions, limitations, and constraints of the project. Describes the services and/or materials to be obtained from the client. | x |  |  |  |  |  |  |  |  |  |  |  |  | 12
 | 1.4 | Deliverables | Defines the final product to be delivered at the end of the project. Defines milestones that progress toward the completion of the final product. Deliverables include a completed prototype, all spare parts, design and technical documentation, and test results. The information is specific to the project, and not described as general project deliverables. | x |  |  |  |  |  |  |  |  |  |  |  |  | 12
Project Research | 2.1 | Review of the Problem Area | Summarizes and synthesizes existing research to support the claims of the problem. Information gathered is technically sound and adequate, e.g., summarizes benchmarked prototypes, patents, research publications, etc. Properly cited work using IEEE style. Includes visual aids (e.g., figures, tables) and technical details to introduce the various claims and approaches published in literature. | x |  |  |  |  |  |  |  |  |  |  |  |  | 12 | 12
 | 2.2 | Review of State-of-the-Art | Introduces relevant products and technologies that exist in research or the market. Introduces appropriate metrics to describe the State-of-Art performance. | x |  |  |  |  |  |  |  |  |  |  |  |  | 12
Project Development | 3.1 | Requirements Matrix | Translates the client's needs into engineering statements using relevant metrics of performance (one, unambiguous and measurable value). Describes the relationships between these statements. Has received Client approval. | x |  |  |  |  |  |  |  |  |  |  |  |  | 12 | 12
 | 3.2 | Exploratory Concepts | Presents (at least) three exploratory designs that can potentially meet the design requirements. Provides evidence to substantiate the validity of the designs. Points out the strengths and weaknesses of each design. Includes sketches and/or models to demonstrate the completeness of the exploratory designs. | x |  |  |  |  |  |  |  |  |  |  |  |  | 12
Team Organization | 4.1 | Member Bios, Team Member Roles | Table includes students' image, name, degree(s), and assigned role(s). | x |  |  |  |  |  |  |  |  |  |  |  |  | 12 | 12
 | 4.2 | Team Charter | Expectations listed for each team member, faculty mentor and customer mentor. | x |  |  |  |  |  |  |  |  |  |  |  |  | 12
Project Management | 10.1 | Project Schedule | Task descriptions contain an acceptable level of detail. Task predecessor links properly used with no open-ended tasks. Task progress bar properly used to indicate % completion status of active tasks. All tasks set to Auto-Schedule mode. All Resource Names added. Milestones identified and properly linked. All task flow in a chronological order. | x |  |  |  |  |  |  |  |  |  |  |  |  | 12 | 12
 | 10.2 | Gantt Charts & Critical Path | Gantt Chart(s): Properly formatted to clearly define project status details and all information in the Gantt Charts is aligned with the Gate requirements. Task level information clearly indicates an appropriate level of detail. Chart types are properly created as defined in the Project Schedule Guidelines. Critical Path: MS Project able to calculate critical path based on existing tasks and predecessor structure. Clearly defined and shown using the Level 3 chart format. Gantt Charts content should be To gate 1 | x |  |  |  |  |  |  |  |  |  |  |  |  | 12
 | 10.3 | MS Teams File Documentation | Certification table filled in and signed by the responsible team member. | x |  |  |  |  |  |  |  |  |  |  |  |  | 12
Report Quality |  | Formatting and References | Uses IEEE format to develop the Title Page, Table of Contents, Appendix, and Work Cited sections of this report. | x |  |  |  |  |  |  |  |  |  |  |  |  | 12 | 12
 |  | Text | Free of spelling and grammatical errors, text flows with contiguous threads, consistent format, use of 3rd person perspective, non-repeating ideas or information. | x |  |  |  |  |  |  |  |  |  |  |  |  | 12
 |  | Visual Aids | Visual aids (all figures including hand sketches, photos, charts, etc. and tables) are clear and readable and of professional quality. Graphic aspects labeled and linked to text to transmit critical information, units/scaling clear. Proper IEEE style utilized. | X |  |  |  |  |  |  |  |  |  |  |  |  | 12
 | A1 | Communication Plan | Communication Plan template fully filled in. Communication channels appear appropriate for the current team progress and level of communication occurring. Clearly defined descriptions of all portions of the plan. | X |  |  |  |  |  |  |  |  |  |  |  |  | 12 | 12
 | A2 | Team Member Bios | Describes each member's motivation to participate and succeed in this project. | x |  |  |  |  |  |  |  |  |  |  |  |  | 12
Comments |  |  |  |  |  |  |  |  |  |  |  |  |  |  |  |  | Total Points | 96
 |  |  |  |  |  |  |  |  |  |  |  |  |  |  |  |  | Points Available | 96
 |  |  |  |  |  |  |  |  |  |  |  |  |  |  |  |  | Grade % | 100%

Sheet: G1.5P
Gate 1.5 Project Status Report - Oral Presentation Rubric
Category | Report Sec. # | Title | Requirements | Meets Expectations (12) | (11) | (10) | (9) | (8) | (7) | (6) | (5) | (4) | (3) | (2) | (1) | No Evidence (0) | Score (0-12) | Avg. Score
Overall Presentation |  | Introduction | Presentation Title (closely matches project name), Outline (follows Rubric), Team Members (photo, name, academic major, team role) Concise overview of project. | x |  |  |  |  |  |  |  |  |  |  |  |  | 12 | 12
 |  | Audio / Visual Quality of Presentation | Figures and tables in engineering format, free of spelling and grammatical errors, data presented is well-organized and defined in tabular or graphical form. Annotations are used to describe key points of photos and graphics. All slides are labeled with page numbers and consistent formatting between slides. Audio quality good no background noise or distractions. | x |  |  |  |  |  |  |  |  |  |  |  |  | 12
 |  | References | References (in-text and bibliography) properly cited in IEEE style. Proper use of the Zotero citation management tool | x |  |  |  |  |  |  |  |  |  |  |  |  | 12
 |  | Oral Presentation Skill | Clear enunciation when discussing engineering design. All members are participating. Smooth transitions between topics and presenters. | x |  |  |  |  |  |  |  |  |  |  |  |  | 12
Comments
Project Definition | 1.1 | Problem Description | Includes context to the problem, reason for the problem, need for this project, defines who is impacted by the problem (customer / market) and how. | x |  |  |  |  |  |  |  |  |  |  |  |  | 12 | 12
 | 1.2 | Problem Statement | Describes the problem in technical detail and Quantifies the impact on the customer/market. Introduce critical performance metrics. Defines the end-user population (e.g., person, environment, or organization). | x |  |  |  |  |  |  |  |  |  |  |  |  | 12
 | 1.3 | Scope of Work | Describes the approach to solve this problem, the projected timeline plan, and the assumptions, limitations, and constraints of the project. Describes the services and/or materials to be obtained from the client. | x |  |  |  |  |  |  |  |  |  |  |  |  | 12
 | 1.4 | Deliverables | Defines the final product to be delivered at the end of the project. Defines milestones that progress toward the completion of the final product. Deliverables include a completed prototype, all spare parts, design and technical documentation, and test results. The information is specific to the project, and not described as general project deliverables. | x |  |  |  |  |  |  |  |  |  |  |  |  | 12
Comments
Project Research | 2.1 | Review of the Problem Area | Summarizes and synthesizes existing research to support the claims of the problem. Information gathered is technically sound and adequate, e.g., summarizes benchmarked prototypes, patents, research publications, etc. Properly cited work using IEEE style. Includes visual aids (e.g., figures, tables) and technical details to introduce the various claims and approaches published in literature. | x |  |  |  |  |  |  |  |  |  |  |  |  | 12 | 12
 | 2.2 | Review of State-of-the-Art | Introduces relevant products and technologies that exist in research or the market. Introduces appropriate metrics to describe the State-of-Art performance. | x |  |  |  |  |  |  |  |  |  |  |  |  | 12
Comments
Project Development | 3.1 | Requirements Matrix | Translates the client's needs into engineering statements using relevant metrics of performance (one, unambiguous and measurable value). Describes the relationships between these statements. Has received Client approval. | x |  |  |  |  |  |  |  |  |  |  |  |  | 12 | 12
 | 3.2 | Exploratory Concepts | Presents (at least) three exploratory designs that can potentially meet the design requirements. Provides evidence to substantiate the validity of the designs. Points out the strengths and weaknesses of each design. Includes sketches and/or models to demonstrate the completeness of the exploratory designs. | x |  |  |  |  |  |  |  |  |  |  |  |  | 12
Comments
Team Organization | 4.1 | Member Bios, Team Member Roles | Table includes students' image, name, degree(s), and assigned role(s). | x |  |  |  |  |  |  |  |  |  |  |  |  | 12 | 12
 | 4.2 | Team Charter | Expectations listed for each team member, faculty mentor and customer mentor. | x |  |  |  |  |  |  |  |  |  |  |  |  | 12
Comments
Design Development | 5.2 | Conceptual Design | Presents (at least) three detailed conceptual designs that can meet the design requirements. Provides evidence to substantiate the validity of the designs. Points out strengths and weaknesses of each. Includes sketches and/or models to demonstrate the completeness of the designs. | X |  |  |  |  |  |  |  |  |  |  |  |  | 12 | 12
 | 5.3 | Down Selection Process | Discusses the results of the Down Selection process, includes the criteria and weighting factors for each criterion. Defines the final selection and explains why. | x |  |  |  |  |  |  |  |  |  |  |  |  | 12 | 12
 | 5.7 | Critical Issues & Risk Mitigation | Explains critical issues that have arisen. Translates critical issues into sequential action items. Explains the affect(s) on the critical path and schedule. | x |  |  |  |  |  |  |  |  |  |  |  |  | 12
Comments
Project Management | 10.1 | Project Schedule | Task descriptions contain an acceptable level of detail. Task predecessor links properly used with no open-ended tasks. Task progress bar properly used to indicate % completion status of active tasks. All tasks set to Auto-Schedule mode. All Resource Names added. Milestones identified and properly linked. All task flow in a chronological order. | x |  |  |  |  |  |  |  |  |  |  |  |  | 12 | 12
 | 10.2 | Gantt Charts & Critical Path | Gantt Chart(s): Properly formatted to clearly define project status details and all information in the Gantt Charts is aligned with the Gate requirements. Task level information clearly indicates an appropriate level of detail. Chart types are properly created as defined in the Project Schedule Guidelines. Critical Path: MS Project able to calculate critical path based on existing tasks and predecessor structure. Clearly defined and shown using the Level 3 chart format. Gantt Charts content should be To gate 1.5 & Gate 2 Tasks. | x |  |  |  |  |  |  |  |  |  |  |  |  | 12
Comments |  |  |  |  |  |  |  |  |  |  |  |  |  |  |  |  | Total Points | 96
 |  |  |  |  |  |  |  |  |  |  |  |  |  |  |  |  | Points Available | 96
 |  |  |  |  |  |  |  |  |  |  |  |  |  |  |  |  | Grade % | 100%

Sheet: G2R
Gate 2 Technical Report Rubric
Category | Report Sec.# | Title | Requirements (Additional information provided in Guidelines_Report.doc) | Meets Expectations (12) | (11) | (10) | (9) | (8) | (7) | (6) | (5) | (4) | (3) | (2) | (1) | No Evidence (0) | Score (0-12) | Weight | Avg. Score
Updated Sections based on feedback from Previous Gate(s) | ii | Executive Summary | Updated for Gate 2 and based upon feedback from previous Gate Report. | x |  |  |  |  |  |  |  |  |  |  |  |  | 12 | 1 | 12
 | 1.3 | Scope of Work |  | x |  |  |  |  |  |  |  |  |  |  |  |  | 12
 | 1.4 | Deliverables |  | x |  |  |  |  |  |  |  |  |  |  |  |  | 12
 | 3.1 | Requirements Matrix |  | x |  |  |  |  |  |  |  |  |  |  |  |  | 12
 | 3.2 | Exploratory Concepts |  | x |  |  |  |  |  |  |  |  |  |  |  |  | 12
 | 10.3 | MS Teams File Documentation |  | x |  |  |  |  |  |  |  |  |  |  |  |  | 12
Project Research | 2.1 | Review of the Problem Area | Summarizes and synthesizes existing research to support the claims of the problem. Information gathered is technically sound and adequate, e.g., summarizes benchmarked prototypes, patents, research publications, etc. Properly cited work using IEEE style. Includes visual aids (e.g., figures, tables) and technical details to introduce the various claims and approaches published in literature. | x |  |  |  |  |  |  |  |  |  |  |  |  | 12 | 1 | 12
 | 2.2 | Review of State-of-the-Art | Introduces relevant products and technologies that exist in research or the market. Introduces appropriate metrics to describe the State-of-Art performance. | x |  |  |  |  |  |  |  |  |  |  |  |  | 12
Project Development | 3.1 | Requirements Matrix | Translates the client's needs into engineering statements using relevant metrics of performance (one, unambiguous and measurable value). Describes the relationships between these statements. Has received Client approval. | x |  |  |  |  |  |  |  |  |  |  |  |  | 12 | 1.5 | 18
 | 3.2 | Exploratory Concepts | Presents (at least) three exploratory designs that can potentially meet the design requirements. Provides evidence to substantiate the validity of the designs. Points out the strengths and weaknesses of each design. Includes sketches and/or models to demonstrate the completeness of the exploratory designs. | x |  |  |  |  |  |  |  |  |  |  |  |  | 12
 | 3.3 | Resource Requirements | Expected resource needs to support the project are clearly defined. Status and timeline of any on-going Investigations into resource availabilities is well defined. | x |  |  |  |  |  |  |  |  |  |  |  |  | 12
Design Development | 5.1 | System Decomposition | Decompose the complexity of the system/problem by describing its constituent components. Break down the complex system/problem into smaller, more manageable parts by building a hierarchical representation of critical subsystems. Depending on the system, you may consider developing a functional decomposition, assembly decomposition, or service-based decomposition. | x |  |  |  |  |  |  |  |  |  |  |  |  | 12 | 1.5 | 18
 | 5.2 | Conceptual Design | Presents (at least) three detailed conceptual designs that can meet the design requirements. Provides evidence to substantiate the validity of the designs. Points out strengths and weaknesses of each. Includes sketches and/or models to demonstrate the completeness of the designs. | x |  |  |  |  |  |  |  |  |  |  |  |  | 12
 | 5.3 | Down Selection Process | Discusses the results of the Down Selection process, includes the criteria and weighting factors for each criterion. Defines the final selection and explains why. | x |  |  |  |  |  |  |  |  |  |  |  |  | 12
 | 5.5 | Design Calculations & Analysis Results | Provide and describe the analytical models used to support the design. (FEA, Electrical simulations, Mechanical analysis) Provide and describe the experiments and measurements that support the design. | x |  |  |  |  |  |  |  |  |  |  |  |  | 12 | 1 | 12
 | 5.6 | Mathematical Modeling (Lit review) | Define all analytical approaches to be used to support confirmation that your system design will meet the client requirements. | x |  |  |  |  |  |  |  |  |  |  |  |  | 12
 | 5.7 | Critical Issues & Risk Mitigation | Explains critical issues that have arisen. Translates critical issues into sequential action items. Explains the affect(s) on the critical path and schedule. | x |  |  |  |  |  |  |  |  |  |  |  |  | 12
Project Management | 10.1 | Project Schedule | Task descriptions contain an acceptable level of detail. Task predecessor links properly used with no open-ended tasks. Task progress bar properly used to indicate % completion status of active tasks. All tasks set to Auto-Schedule mode. All Resource Names added. Milestones identified and properly linked. All task flow in a chronological order. | x |  |  |  |  |  |  |  |  |  |  |  |  | 12 | 0.75 | 9
 | 10.2 | Gantt Charts & Critical Path | Gantt Chart(s): Properly formatted to clearly define project status details and all information in the Gantt Charts is aligned with the Gate requirements. Task level information clearly indicates an appropriate level of detail. Chart types are properly created as defined in the Project Schedule Guidelines. Critical Path: MS Project able to calculate critical path based on existing tasks and predecessor structure. Clearly defined and shown using the Level 3 chart format. Gantt Charts content should be To gate 3 Tasks. | x |  |  |  |  |  |  |  |  |  |  |  |  | 12
Report Quality |  | Formatting and References | Uses IEEE format to develop the Title Page, Table of Contents, Appendix, and Work Cited sections of this report. | x |  |  |  |  |  |  |  |  |  |  |  |  | 12 | 1 | 12
 |  | Text | Free of spelling and grammatical errors, text flows with contiguous threads, consistent format, use of 3rd person perspective, non-repeating ideas or information. | x |  |  |  |  |  |  |  |  |  |  |  |  | 12
 |  | Visual Aids | Visual aids (all figures including hand sketches, photos, charts, etc. and tables) are clear and readable and of professional quality. Graphic aspects labeled and linked to text to transmit critical information, units/scaling clear. Proper IEEE style utilized. | x |  |  |  |  |  |  |  |  |  |  |  |  | 12
 | A3 | Down Selection Process | Copy of calculation results for each down selection analysis completed. | x |  |  |  |  |  |  |  |  |  |  |  |  | 12 | 0.25 | 3
 | A4 | Team Meeting Notes | Contains invitees, attendees, agenda, meeting notes, and task assignment with team member responsibilities clearly labeled. | x |  |  |  |  |  |  |  |  |  |  |  |  | 12
Comments |  |  |  |  |  |  |  |  |  |  |  |  |  |  |  |  | Total Points |  | 96
 |  |  |  |  |  |  |  |  |  |  |  |  |  |  |  |  | Points Available |  | 96
 |  |  |  |  |  |  |  |  |  |  |  |  |  |  |  |  | Grade % |  | 100%

Sheet: G2.5P
Gate 2.5 Project Status Report - Oral Presentation Rubric
Category | Report Sec. # | Title | Requirements | Meets Expectations (12) | (11) | (10) | (9) | (8) | (7) | (6) | (5) | (4) | (3) | (2) | (1) | No Evidence (0) | Score (0-12) | Weight | Avg. Score
Overall Presentation |  | Introduction | Presentation Title (closely matches project name), Outline (follows Rubric), Team Members (photo, name, academic major, team role) Concise overview of project. | x |  |  |  |  |  |  |  |  |  |  |  |  | 12 | 1 | 12
 |  | Audio / Visual Quality of Presentation | Figures and tables in engineering format, free of spelling and grammatical errors, data presented is well-organized and defined in tabular or graphical form. Annotations are used to describe key points of photos and graphics. All slides are labeled with page numbers and consistent formatting between slides. Audio quality good no background noise or distractions. | x |  |  |  |  |  |  |  |  |  |  |  |  | 12
 |  | References | References (in-text and bibliography) properly cited in IEEE style. Proper use of the Zotero citation management tool | x |  |  |  |  |  |  |  |  |  |  |  |  | 12
 |  | Oral Presentation Skill | Clear enunciation when discussing engineering design. All members are participating. Smooth transitions between topics and presenters. | x |  |  |  |  |  |  |  |  |  |  |  |  | 12
Comments
Project introduction | 1.1 | Problem Description | Includes context to the problem, reason for the problem, need for this project, defines who is impacted by the problem (customer / market) and how. | x |  |  |  |  |  |  |  |  |  |  |  |  | 12 | 1 | 12
 | 1.2 | Problem Statement | Describes the problem in technical detail and Quantifies the impact on the customer/market. Introduce critical performance metrics. Defines the end-user population (e.g., person, environment, or organization). | x |  |  |  |  |  |  |  |  |  |  |  |  | 12
 | 1.3 | Scope of Work | Describes the approach to solve this problem, the projected timeline plan, and the assumptions, limitations, and constraints of the project. Describes the services and/or materials to be obtained from the client. | x |  |  |  |  |  |  |  |  |  |  |  |  | 12
 | 5.1 | System Decomposition | Decompose the complexity of the system/problem by describing its constituent components. Break down the complex system/problem into smaller, more manageable parts by building a hierarchical representation of critical subsystems. Depending on the system, you may consider developing a functional decomposition, assembly decomposition, or service-based decomposition. | x |  |  |  |  |  |  |  |  |  |  |  |  | 12
Comments
Design Development | 5.4 | Final Design Description | Describes all aspects of the final design and how it meets the client's requirements. | x |  |  |  |  |  |  |  |  |  |  |  |  | 12 | 2 | 24
 | 5.5 | Design Calculations & Analysis Results | Provide and describe the analytical models used to support the design. (FEA, Electrical simulations, Mechanical analysis) Provide and describe the experiments and measurements that support the design. | x |  |  |  |  |  |  |  |  |  |  |  |  | 12
 | 5.6 | Mathematical Modeling (Lit review) | Define all analytical approaches to be used to support confirmation that your system design will meet the client requirements. | x |  |  |  |  |  |  |  |  |  |  |  |  | 12
 | 5.7 | Critical Issues & Risk Mitigation | Explains critical issues that have arisen. Translates critical issues into sequential action items. Explains the affect(s) on the critical path and schedule. | x |  |  |  |  |  |  |  |  |  |  |  |  | 12
Comments
Technical Design Documentation | 6.1 | Mechanical Design | Provides a mechanical description for the project design with sufficient detail for fabrication/manufacturing/assembly. The descriptions include tolerances, part numbering, and material specifications. Provides a manufacturing plan for each part. | x |  |  |  |  |  |  |  |  |  |  |  |  | 12 | 2 | 24
 | 6.2 | Electrical Design | Provides an electrical description for the project design with sufficient detail for fabrication/manufacturing/assembly. Provides complete circuit diagrams. Evaluates the results of circuit breadboards. Provides complete wiring diagrams including cables and connectors. Provides a PC board layout ready for production including mounting points. | x |  |  |  |  |  |  |  |  |  |  |  |  | 12
 | 6.3 | Software & Programming | Provides a description of the software for the project with sufficient detail for reproducibility and troubleshooting. Includes complete flow diagrams including links and operating interfaces. | x |  |  |  |  |  |  |  |  |  |  |  |  | 12
 | 6.5 | System Design Bill of Materials (BOM) | Provide a completed Design Bill of Materials table that defines each system grouping with its associated assemblies and individual parts fully defined. Each line item in the table has an identifiable part numbering system created by the team. | x |  |  |  |  |  |  |  |  |  |  |  |  | 12
Comments
Project Budget & Expenses | 8.4 | Established Project Budget | Describe the amount of funds that will be available to procure all necessary parts and materials to build your prototype. | x |  |  |  |  |  |  |  |  |  |  |  |  | 12 |  | 12
 | 8.5 | Prototype Parts Expense | Tabulate the total expenses for the various systems of your project, such as, ‘Mechanical Parts’, ‘Electrical Components’, ‘Supplies’, ‘Electrical Suppliers’, ‘Special Tools”, etc. | x |  |  |  |  |  |  |  |  |  |  |  |  | 12
 | 8.6 | Budget Summary | Provide a summary of the status of all expenses and available budget amounts. | x |  |  |  |  |  |  |  |  |  |  |  |  | 12
Comments
Project Management | 10.1 | Project Schedule | Task descriptions contain an acceptable level of detail. Task predecessor links properly used with no open-ended tasks. Task progress bar properly used to indicate % completion status of active tasks. All tasks set to Auto-Schedule mode. All Resource Names added. Milestones identified and properly linked. All task flow in a chronological order. | x |  |  |  |  |  |  |  |  |  |  |  |  | 12 |  | 12
 | 10.2 | Gantt Charts & Critical Path | Gantt Chart(s): Properly formatted to clearly define project status details and all information in the Gantt Charts is aligned with the Gate requirements. Task level information clearly indicates an appropriate level of detail. Chart types are properly created as defined in the Project Schedule Guidelines. Critical Path: MS Project able to calculate critical path based on existing tasks and predecessor structure. Clearly defined and shown using the Level 3 chart format. Gantt Charts content should be To gate 3 Tasks. | x |  |  |  |  |  |  |  |  |  |  |  |  | 12
Comments | Well prepared presentation. Please remember to introduce the separate objectives of the different team members. |  |  |  |  |  |  |  |  |  |  |  |  |  |  |  | Total Points |  | 96
 |  |  |  |  |  |  |  |  |  |  |  |  |  |  |  |  | Points Available |  | 96
 |  |  |  |  |  |  |  |  |  |  |  |  |  |  |  |  | Grade % |  | 100%

Sheet: G3P
Gate 3 Concept Demonstration Video
Category | Report Sec. # | Title | Requirements (Additional information provided in Guidelines_Report.doc) | Meets Expectations (12) | (11) | (10) | (9) | (8) | (7) | (6) | (5) | (4) | (3) | (2) | (1) | No Evidence (0) | Score (0-12) | Weight | Avg. Score
Overall Presentation |  | Oral Presentation Skill | Clear enunciation when discussing engineering design. All members are participating. Smooth transitions between topics and presenters. | x |  |  |  |  |  |  |  |  |  |  |  |  | 12 | 1.5 | 18
 |  | Audio / Visual Quality of Presentation | Figures and tables in engineering format, free of spelling and grammatical errors, data presented is well-organized and defined in tabular or graphical form. Annotations are used to describe key points of photos and graphics. All slides are labeled with page numbers and consistent formatting between slides. Audio quality good no background noise or distractions. | x |  |  |  |  |  |  |  |  |  |  |  |  | 12
 |  | References | References (in-text and bibliography) properly cited in IEEE style. Proper use of the Zotero citation management tool | x |  |  |  |  |  |  |  |  |  |  |  |  | 12
Comments
Project Definition | 1.1 | Problem Description | Includes context to the problem, reason for the problem, need for this project, defines who is impacted by the problem (customer / market) and how. | x |  |  |  |  |  |  |  |  |  |  |  |  | 12 | 1 | 12
 | 1.2 | Problem Statement | Describes the problem in technical detail and Quantifies the impact on the customer/market. Introduce critical performance metrics. Defines the end-user population (e.g., person, environment, or organization). | x |  |  |  |  |  |  |  |  |  |  |  |  | 12
 | 1.3 | Scope of Work | Describes the approach to solve this problem, the projected timeline plan, and the assumptions, limitations, and constraints of the project. Describes the services and/or materials to be obtained from the client. | X |  |  |  |  |  |  |  |  |  |  |  |  | 12
 | 5.1 | System Decomposition | Decompose the complexity of the system/problem by describing its constituent components. Break down the complex system/problem into smaller, more manageable parts by building a hierarchical representation of critical subsystems. Depending on the system, you may consider developing a functional decomposition, assembly decomposition, or service-based decomposition. | x |  |  |  |  |  |  |  |  |  |  |  |  | 12
Comments
Design Development |  | Concept Evolution (Inspiration + Creativity) | Presents the evolution of your design by illustrating the developments made throughout the exploratory/conceptual/down-selection design phases. Points out the strengths and weaknesses of each design. Provides evidence to validate the concept selection. | x |  |  |  |  |  |  |  |  |  |  |  |  | 12 | 2.5 | 30
 |  | Quality of Science | Demonstrates critical thinking skills to evaluate technical and market viability. Is the problem and assessment structured/justified. Standards & industrial accepted methods of assessment, logic, reasoning, (core principles) evidence. | x |  |  |  |  |  |  |  |  |  |  |  |  | 12
 |  | Quality of Prototype & Model | Prototype demonstrates proof-of-concept for at least 1 key functional and/or customer requirement. Demo of critical principles, scaled, off-the-shelf, | x |  |  |  |  |  |  |  |  |  |  |  |  | 12
Comments
Preliminary Results |  | Comparison of results | Compare your experimental results to the theory. Describe the mathematical model(s) used to predict product performance (e.g., FEA, Electrical simulations, Mechanical analysis). Describe the experiments and measurements that support the design methodology. | x |  |  |  |  |  |  |  |  |  |  |  |  | 12 | 2.5 | 30
 |  | Interpretation of Results | List most important lessons learned by sharing experiences of how new and improved techniques or processes were developed and how they were instrumental in achieving your design requirements. | X |  |  |  |  |  |  |  |  |  |  |  |  | 12
 |  | Future Work | Describe the next steps that you would take in this work. Formulate any questions that your results may raise and whether alternative steps should be considered in future work. | X |  |  |  |  |  |  |  |  |  |  |  |  | 12
Comments
Demonstration |  | Demo Video | Video uploaded into the proper location(s) | x |  |  |  |  |  |  |  |  |  |  |  |  | 12 | 0.5 | 6
Comments |  |  |  |  |  |  |  |  |  |  |  |  |  |  |  |  | Total Points |  | 96
 |  |  |  |  |  |  |  |  |  |  |  |  |  |  |  |  | Points Available |  | 96
 |  |  |  |  |  |  |  |  |  |  |  |  |  |  |  |  | Grade % |  | 100%

Sheet: G4R
Gate 4 Technical Report Rubric
Category | Report Sec. # | Title | Requirements (Additional information provided in Guidelines_Report.doc) | Meets Expectations (12) | (11) | (10) | (9) | (8) | (7) | (6) | (5) | (4) | (3) | (2) | (1) | No Evidence (0) | Score (0-12) | Weight | Avg. Score
Updated Sections based on feedback from Previous Gate(s) | ii | Executive Summary | Gate 4 adjusted based upon project status and feedback from previous Gate Reports. | x |  |  |  |  |  |  |  |  |  |  |  |  | 12 | 1 | 12
 | 2.1 | Review of the Problem Area |  | x |  |  |  |  |  |  |  |  |  |  |  |  | 12
 | 2.2 | Review of State-of-the-Art |  | x |  |  |  |  |  |  |  |  |  |  |  |  | 12
 | 3.1 | Requirements Matrix |  | x |  |  |  |  |  |  |  |  |  |  |  |  | 12
 | 3.2 | Exploratory Concepts |  | x |  |  |  |  |  |  |  |  |  |  |  |  | 12
 | 3.3 | Resource Requirements |  | x |  |  |  |  |  |  |  |  |  |  |  |  | 12
 | 5.2 | Conceptual Design
 | 5.3 | Down Selection Process |  | x |  |  |  |  |  |  |  |  |  |  |  |  | 12
 | 10.3 | MS Teams File Documentation |  | x |  |  |  |  |  |  |  |  |  |  |  |  | 12
 | A1-4 | Update Appendices |  | x |  |  |  |  |  |  |  |  |  |  |  |  | 12
Design Development | 5.4 | Final Design Description | Describes all aspects of the final design and how it meets the client's requirements. | x |  |  |  |  |  |  |  |  |  |  |  |  | 12 | 1 | 12
 | 5.5 | Design Calculations & Analysis Results | Provide and describe the analytical models used to support the design. (FEA, Electrical simulations, Mechanical analysis) Provide and describe the experiments and measurements that support the design. | x |  |  |  |  |  |  |  |  |  |  |  |  | 12
 | 5.6 | Mathematical Modeling (Lit review) | Define all analytical approaches to be used to support confirmation that your system design will meet the client requirements. | x |  |  |  |  |  |  |  |  |  |  |  |  | 12
 | 5.7 | Critical Issues & Risk Mitigation | Explains critical issues that have arisen. Translates critical issues into sequential action items. Explains the affect(s) on the critical path and schedule. | x |  |  |  |  |  |  |  |  |  |  |  |  | 12
Technical Documentation | 6.1 | Mechanical Design | Provides a mechanical description for the project design with sufficient detail for fabrication/manufacturing/assembly. The descriptions include tolerances, part numbering, and material specifications. Provides a manufacturing plan for each part. | x |  |  |  |  |  |  |  |  |  |  |  |  | 12 | 1.5 | 18
 | 6.2 | Electrical Design | Provides an electrical description for the project design with sufficient detail for fabrication/manufacturing/assembly. Provides complete circuit diagrams. Evaluates the results of circuit breadboards. Provides complete wiring diagrams including cables and connectors. Provides a PC board layout ready for production including mounting points. | x |  |  |  |  |  |  |  |  |  |  |  |  | 12
 | 6.3 | Software & Programming | Provides a description of the software for the project with sufficient detail for reproducibility and troubleshooting. Includes complete flow diagrams including links and operating interfaces. | x |  |  |  |  |  |  |  |  |  |  |  |  | 12
 | 6.4 | Technical Data Sheets | Introduce the equipment and purpose of use, and reference data sheet in Appendix. | x |  |  |  |  |  |  |  |  |  |  |  |  | 12
 | 6.5 | System Design Bill of Materials (BOM) | Provide a completed Design Bill of Materials table that defines each system grouping with its associated assemblies and individual parts fully defined. Each line item in the table has an identifiable part numbering system created by the team. | x |  |  |  |  |  |  |  |  |  |  |  |  | 12
Test Plan & Testing Phase | 9.1 | Test Plan & Testing Phase | Well defined test plan appropriate to the expected level of testing. Testing requirements and test sequences developed and data recording methods identified. All test equipment and sensor needs have been identified and ordered. Clearly defined plan in place for the type of data analysis method(s) to be used. Test location Identified and outside resources identified and ready to support testing as needed. | x |  |  |  |  |  |  |  |  |  |  |  |  | 12 | 1.5 | 18
 | 9.2 | Test Results and Data Analysis | Captured test data properly documented and organized. Analysis of test data clearly justifies the final conclusions of the test efforts. | x |  |  |  |  |  |  |  |  |  |  |  |  | 12
Prototype Development & Budget Plan | 8.1 | Parts Requisition | Parts ordering needs clearly defined. Parts Requisition Form filled in correctly and submitted. Summary table clearly defines all parts ordered. Parts delivery dates clearly defined. Copies of all forms submitted have been placed in Appendix A9. | x |  |  |  |  |  |  |  |  |  |  |  |  | 12 | 1 | 12
 | 8.2 | Fabrication Plan | Fabrication plan clearly defined. All special assembly or testing needs are described. Alternate build techniques and materials identified for costly or long lead-time components. Inspection plan clearly defined for all fabricated or purchased components. | x |  |  |  |  |  |  |  |  |  |  |  |  | 12
 | 8.4 | Established Project Budget | Describe the amount of funds that will be available to procure all necessary parts and materials to build your prototype. | x |  |  |  |  |  |  |  |  |  |  |  |  | 12
 | 8.5 | Prototype Parts Expense | Tabulate the total expenses for the various systems of your project, such as, ‘Mechanical Parts’, ‘Electrical Components’, ‘Supplies’, ‘Electrical Suppliers’, ‘Special Tools”, etc. | x |  |  |  |  |  |  |  |  |  |  |  |  | 12
 | 8.6 | Budget Summary | Provide a summary of the status of all expenses and available budget amounts. | x |  |  |  |  |  |  |  |  |  |  |  |  | 12
Project Management | 10.1 | Project Schedule | Task descriptions contain an acceptable level of detail. Task predecessor links properly used with no open-ended tasks. Task progress bar properly used to indicate % completion status of active tasks. All tasks set to Auto-Schedule mode. All Resource Names added. Milestones identified and properly linked. All task flow in a chronological order. | x |  |  |  |  |  |  |  |  |  |  |  |  | 12 | 0.5 | 6
 | 10.2 | Gantt Charts & Critical Path | Gantt Chart(s): Properly formatted to clearly define project status details and all information in the Gantt Charts is aligned with the Gate requirements. Task level information clearly indicates an appropriate level of detail. Chart types are properly created as defined in the Project Schedule Guidelines. Critical Path: MS Project able to calculate critical path based on existing tasks and predecessor structure. Clearly defined and shown using the Level 3 chart format. Gantt Charts content should be To gate 6 Tasks. | x |  |  |  |  |  |  |  |  |  |  |  |  | 12
Report Quality |  | Formatting and References | Uses IEEE format to develop the Title Page, Table of Contents, Appendix, and Work Cited sections of this report. | x |  |  |  |  |  |  |  |  |  |  |  |  | 12 | 1 | 12
 |  | Text | Free of spelling and grammatical errors, text flows with contiguous threads, consistent format, use of 3rd person perspective, non-repeating ideas or information. | x |  |  |  |  |  |  |  |  |  |  |  |  | 12
 |  | Visual Aids | Visual aids (all figures including hand sketches, photos, charts, etc. and tables) are clear and readable and of professional quality. Graphic aspects labeled and linked to text to transmit critical information, units/scaling clear. Proper IEEE style utilized. | x |  |  |  |  |  |  |  |  |  |  |  |  | 12
 | A1 | Communication Plan | Communication Plan template fully filled in. Communication channels appear appropriate for the current team progress and level of communication occurring. Clearly defined descriptions of all portions of the plan. | x |  |  |  |  |  |  |  |  |  |  |  |  | 12 | 0.5 | 6
 | A2 | Team Member Bios | Describes each member's motivation to participate and succeed in this project. | x |  |  |  |  |  |  |  |  |  |  |  |  | 12
 | A3 | Down Selection Process | Copy of calculation results for each down selection analysis completed. | x |  |  |  |  |  |  |  |  |  |  |  |  | 12
 | A4 | Team Meeting Notes | Contains invitees, attendees, agenda, meeting notes, and task assignment with team member responsibilities clearly labeled. | x |  |  |  |  |  |  |  |  |  |  |  |  | 12
 | A5 | Mechanical Drawings | Provides a full engineering mechanical description and documentation for the project design in sufficient detail that the design could be manufactured/produced/assembled. | x |  |  |  |  |  |  |  |  |  |  |  |  | 12
 | A6 | Electrical Drawings | Provides a full engineering electrical description and documentation for the project design in sufficient detail that the design could be manufactured/produced/assembled. | x |  |  |  |  |  |  |  |  |  |  |  |  | 12
 | A7 | Software and Programming Files | Provides a full engineering software description and documentation for the project design in sufficient detail that the program can be reproduced. | x |  |  |  |  |  |  |  |  |  |  |  |  | 12
 | A8 | Technical Data Sheets | All manufacturers' data sheets attached. | x |  |  |  |  |  |  |  |  |  |  |  |  | 12
 | A9 | Failure Modes and Effects Analysis (FMEA)
 | A10 | Parts Requisition Forms | Contains copies of all parts requisition form submitted | x |  |  |  |  |  |  |  |  |  |  |  |  | 12
Comments |  |  |  |  |  |  |  |  |  |  |  |  |  |  |  |  | Total Points |  | 96
 |  |  |  |  |  |  |  |  |  |  |  |  |  |  |  |  | Points Available |  | 96
 |  |  |  |  |  |  |  |  |  |  |  |  |  |  |  |  | Grade % |  | 100%

Sheet: G4.5D
Gate 4.5 Demonstration Video
Category | Report Sec. # | Title | Requirements (Additional information provided in Guidelines_Report.doc) | Meets Expectations (12) | (11) | (10) | (9) | (8) | (7) | (6) | (5) | (4) | (3) | (2) | (1) | No Evidence (0) | Score (0-12) | Weight | Avg. Score
Overall Presentation |  | Oral Presentation Skill | Clear enunciation when discussing engineering design. All members are participating. Smooth transitions between topics and presenters. | X |  |  |  |  |  |  |  |  |  |  |  |  | 12 | 1.5 | 18
 |  | Audio / Visual Quality of Presentation | Figures and tables in engineering format, free of spelling and grammatical errors, data presented is well-organized and defined in tabular or graphical form. Annotations are used to describe key points of photos and graphics. All slides are labeled with page numbers and consistent formatting between slides. Audio quality good no background noise or distractions. | X |  |  |  |  |  |  |  |  |  |  |  |  | 12
 |  | References | References (in-text and bibliography) properly cited in IEEE style. Proper use of the Zotero citation management tool | X |  |  |  |  |  |  |  |  |  |  |  |  | 12
Comments
Project Definition | 1.1 | Problem Description | Includes context to the problem, reason for the problem, need for this project, defines who is impacted by the problem (customer / market) and how. | X |  |  |  |  |  |  |  |  |  |  |  |  | 12 | 1.5 | 18
 | 1.2 | Problem Statement | Describes the problem in technical detail and Quantifies the impact on the customer/market. Introduce critical performance metrics. Defines the end-user population (e.g., person, environment, or organization). | X |  |  |  |  |  |  |  |  |  |  |  |  | 12
 | 1.3 | Scope of Work | Describes the approach to solve this problem, the projected timeline plan, and the assumptions, limitations, and constraints of the project. Describes the services and/or materials to be obtained from the client. | x |  |  |  |  |  |  |  |  |  |  |  |  | 12
Comments
Project Research | 2.1 | Review of the Problem Area | Summarizes and synthesizes existing research to support the claims of the problem. Information gathered is technically sound and adequate, e.g., summarizes benchmarked prototypes, patents, research publications, etc. Properly cited work using IEEE style. Includes visual aids (e.g., figures, tables) and technical details to introduce the various claims and approaches published in literature. | X |  |  |  |  |  |  |  |  |  |  |  |  | 12 | 1.5 | 18
 | 2.2 | Review of State-of-the-Art | Introduces relevant products and technologies that exist in research or the market. Introduces appropriate metrics to describe the State-of-Art performance. | X |  |  |  |  |  |  |  |  |  |  |  |  | 12
Comments
Design Development | 5.4 | Final Design Description | Describes all aspects of the final design and how it meets the client's requirements. | X |  |  |  |  |  |  |  |  |  |  |  |  | 12 | 1.5 | 18
 | 5.6 | Mathematical Modeling (Lit review) | Define all analytical approaches to be used to support confirmation that your system design will meet the client requirements. | X |  |  |  |  |  |  |  |  |  |  |  |  | 12
Comments
Demonstration |  | Demo Video | Video uploaded into the proper location(s) | X |  |  |  |  |  |  |  |  |  |  |  |  | 12 | 2 | 24
Comments |  |  |  |  |  |  |  |  |  |  |  |  |  |  |  |  | Total Points |  | 96
 |  |  |  |  |  |  |  |  |  |  |  |  |  |  |  |  | Points Available |  | 96
 |  |  |  |  |  |  |  |  |  |  |  |  |  |  |  |  | Grade % |  | 100%

Sheet: G5R
Gate 5 Technical Report Rubric
Category | Report Sec. # | Title | Requirements (Additional information provided in Guidelines_Report.doc) | Meets Expectations (12) | (11) | (10) | (9) | (8) | (7) | (6) | (5) | (4) | (3) | (2) | (1) | No Evidence (0) | Score (0-12) | Weight | Avg. Score
Updated Sections based on feedback from Previous Gate(s) | ii | Executive Summary | Updated for Gate 5 and based upon feedback from previous Gate Report. |  |  |  | x |  |  |  |  |  |  |  |  |  | 9 | 1 | 11.7
 | 5.3 | Down Selection Process |  | x |  |  |  |  |  |  |  |  |  |  |  |  | 12
 | 5.4 | Final Design Description |  | x |  |  |  |  |  |  |  |  |  |  |  |  | 12
 | 5.5 | Design Calculations & Analysis Results |  | x |  |  |  |  |  |  |  |  |  |  |  |  | 12
 | 5.6 | Mathematical Modeling (Lit review) |  | x |  |  |  |  |  |  |  |  |  |  |  |  | 12
 | 6.5 | System Design Bill of Materials (BOM) |  | x |  |  |  |  |  |  |  |  |  |  |  |  | 12
 | 7.1 | Failure Modes and Effects Analysis (FMEA) |  | x |  |  |  |  |  |  |  |  |  |  |  |  | 12
 | 8.1 | Parts Requisition |  | x |  |  |  |  |  |  |  |  |  |  |  |  | 12
 | 8.2 | Fabrication Plan |  | x |  |  |  |  |  |  |  |  |  |  |  |  | 12
 | 10.3 | MS Teams File Documentation |  | x |  |  |  |  |  |  |  |  |  |  |  |  | 12
Technical Documentation | 6.1 | Mechanical Design | Provides a mechanical description for the project design with sufficient detail for fabrication/manufacturing/assembly. The descriptions include tolerances, part numbering, and material specifications. Provides a manufacturing plan for each part. | x |  |  |  |  |  |  |  |  |  |  |  |  | 12 | 1 | 12
 | 6.2 | Electrical Design | Provides an electrical description for the project design with sufficient detail for fabrication/manufacturing/assembly. Provides complete circuit diagrams. Evaluates the results of circuit breadboards. Provides complete wiring diagrams including cables and connectors. Provides a PC board layout ready for production including mounting points. | x |  |  |  |  |  |  |  |  |  |  |  |  | 12
 | 6.3 | Software & Programming | Provides a description of the software for the project with sufficient detail for reproducibility and troubleshooting. Includes complete flow diagrams including links and operating interfaces. | x |  |  |  |  |  |  |  |  |  |  |  |  | 12
 | 6.4 | Technical Data Sheets | Introduce the equipment and purpose of use, and reference data sheet in Appendix. | x |  |  |  |  |  |  |  |  |  |  |  |  | 12
FMEA | 7.1 | Failure Modes and Effects Analysis (FMEA) | Provide a Failure Modes and Effects Analysis (FMEA) with discussion of results. Components used for the device should be included. Tooling test equipment should not be included. style. Include the appropriate level of visual aids (e.g., figures, tables) and technical detail to clearly define the various approaches researched. | x |  |  |  |  |  |  |  |  |  |  |  |  | 12 | 1 | 12
Prototype Development | 8.3 | As Built / Implemented Documentation | Describe the differences between the 'as built' design vs. the intended design features. Provide sketches and/or CAD models as visual aids to support your description of the design differences. Explain how the as built prototype features may impact capturing data during the testing phase. Define any test plan modifications needed to capture your data. | x |  |  |  |  |  |  |  |  |  |  |  |  | 12 | 1 | 12
Test and Evaluation | 9.1 | Test Plan & Testing Phase | Well defined test plan appropriate to the expected level of testing. Testing requirements and test sequences developed and data recording methods identified. All test equipment and sensor needs have been identified and ordered. Clearly defined plan in place for the type of data analysis method(s) to be used. Test location Identified and outside resources identified and ready to support testing as needed. | x |  |  |  |  |  |  |  |  |  |  |  |  | 12 | 2 | 24
 | 9.2 | Test Results and Data Analysis | Captured test data properly documented and organized. Analysis of test data clearly justifies the final conclusions of the test efforts. | x |  |  |  |  |  |  |  |  |  |  |  |  | 12
 | 9.3 | Corrective Action Plan (if needed) | If a product performance deficiency is found during test data analysis, create a detailed Corrective Action Plan that describes each deficiency found and how it will impact meeting the client requirements, deliverables, and your project schedule. This action plan should be thoroughly reviewed and approved by the client. | x |  |  |  |  |  |  |  |  |  |  |  |  | 12
Project Management | 10.1 | Project Schedule | Task descriptions contain an acceptable level of detail. Task predecessor links properly used with no open-ended tasks. Task progress bar properly used to indicate % completion status of active tasks. All tasks set to Auto-Schedule mode. All Resource Names added. Milestones identified and properly linked. All task flow in a chronological order. | x |  |  |  |  |  |  |  |  |  |  |  |  | 12 | 0.5 | 6
 | 10.2 | Gantt Charts & Critical Path | Gantt Chart(s): Properly formatted to clearly define project status details and all information in the Gantt Charts is aligned with the Gate requirements. Task level information clearly indicates an appropriate level of detail. Chart types are properly created as defined in the Project Schedule Guidelines. Critical Path: MS Project able to calculate critical path based on existing tasks and predecessor structure. Clearly defined and shown using the Level 3 chart format. Gantt Charts content should be To gate 6 Tasks. | x |  |  |  |  |  |  |  |  |  |  |  |  | 12
Report Quality |  | Formatting and References | Uses IEEE format to develop the Title Page, Table of Contents, Appendix, and Work Cited sections of this report. | x |  |  |  |  |  |  |  |  |  |  |  |  | 12 | 1 | 12
 |  | Text | Free of spelling and grammatical errors, text flows with contiguous threads, consistent format, use of 3rd person perspective, non-repeating ideas or information. | x |  |  |  |  |  |  |  |  |  |  |  |  | 12
 |  | Visual Aids | Visual aids (all figures including hand sketches, photos, charts, etc. and tables) are clear and readable and of professional quality. Graphic aspects labeled and linked to text to transmit critical information, units/scaling clear. Proper IEEE style utilized. | x |  |  |  |  |  |  |  |  |  |  |  |  | 12
 | A5 | Mechanical Drawings | Provides a full engineering mechanical description and documentation for the project design in sufficient detail that the design could be manufactured/produced/assembled. | x |  |  |  |  |  |  |  |  |  |  |  |  | 12 | 0.5 | 6
 | A6 | Electrical Drawings | Provides a full engineering electrical description and documentation for the project design in sufficient detail that the design could be manufactured/produced/assembled. | x |  |  |  |  |  |  |  |  |  |  |  |  | 12
 | A7 | Software and Programming Files | Provides a full engineering software description and documentation for the project design in sufficient detail that the program can be reproduced. | x |  |  |  |  |  |  |  |  |  |  |  |  | 12
 | A8 | Technical Data Sheets | All manufacturers' data sheets attached. | x |  |  |  |  |  |  |  |  |  |  |  |  | 12
 | A9 | Failure Modes and Effects Analysis (FMEA) | Attach the FMEA in the Appendix | x |  |  |  |  |  |  |  |  |  |  |  |  | 12
 | A10 | Parts Requisition Forms | Contains copies of all parts requisition form submitted | x |  |  |  |  |  |  |  |  |  |  |  |  | 12
Comments |  |  |  |  |  |  |  |  |  |  |  |  |  |  |  |  | Total Points |  | 95.7
 |  |  |  |  |  |  |  |  |  |  |  |  |  |  |  |  | Points Available |  | 96
 |  |  |  |  |  |  |  |  |  |  |  |  |  |  |  |  | Grade % |  | 99.6875%

Sheet: G5.5D
Gate 5.5 Demonstration Video
Category | Report Sec. # | Title | Requirements (Additional information provided in Guidelines_Report.doc) | Meets Expectations (12) | (11) | (10) | (9) | (8) | (7) | (6) | (5) | (4) | (3) | (2) | (1) | No Evidence (0) | Score (0-12) | Weight | Avg. Score
Overall Presentation |  | Oral Presentation Skill | Clear enunciation when discussing engineering design. All members are participating. Smooth transitions between topics and presenters. | x |  |  |  |  |  |  |  |  |  |  |  |  | 12 | 1.5 | 18
 |  | Audio / Visual Quality of Presentation | Figures and tables in engineering format, free of spelling and grammatical errors, data presented is well-organized and defined in tabular or graphical form. Annotations are used to describe key points of photos and graphics. All slides are labeled with page numbers and consistent formatting between slides. Audio quality good no background noise or distractions. | x |  |  |  |  |  |  |  |  |  |  |  |  | 12
 |  | References | References (in-text and bibliography) properly cited in IEEE style. Proper use of the Zotero citation management tool | x |  |  |  |  |  |  |  |  |  |  |  |  | 12
Comments
Project Definition | 1.1 | Problem Description | Includes context to the problem, reason for the problem, need for this project, defines who is impacted by the problem (customer / market) and how. | x |  |  |  |  |  |  |  |  |  |  |  |  | 12 | 1.5 | 18
 | 1.2 | Problem Statement | Describes the problem in technical detail and Quantifies the impact on the customer/market. Introduce critical performance metrics. Defines the end-user population (e.g., person, environment, or organization). | x |  |  |  |  |  |  |  |  |  |  |  |  | 12
 | 1.3 | Scope of Work | Describes the approach to solve this problem, the projected timeline plan, and the assumptions, limitations, and constraints of the project. Describes the services and/or materials to be obtained from the client. | x |  |  |  |  |  |  |  |  |  |  |  |  | 12
Comments
Design Development |  | Design Evolution | Presents the evolution of your design by illustrating the developments made throughout the exploratory/conceptual/down-selection design phases. Points out the strengths and weaknesses of each design. Provides evidence to validate the concept selection. | x |  |  |  |  |  |  |  |  |  |  |  |  | 12 | 1.5 | 18
 | 5.4 | Final Design Description | Describes all aspects of the final design and how it meets the client's requirements. | x |  |  |  |  |  |  |  |  |  |  |  |  | 12
Comments
Results & Conclusions |  | Comparison of results | Compare your experimental results to the theory. Describe the mathematical model(s) used to predict product performance (e.g., FEA, Electrical simulations, Mechanical analysis). Describe the experiments and measurements that support the design methodology. | x |  |  |  |  |  |  |  |  |  |  |  |  | 12 | 1.5 | 18
 | 11.2 | Lessons Learned | List most important lessons learned by sharing experiences of how new and improved techniques or processes were developed and how they were instrumental in achieving your design requirements. | X |  |  |  |  |  |  |  |  |  |  |  |  | 12
 | 11.3 | Recommendations | Describe all team recommendations with enough detail to best direct your client to initiate future action within their company. Create a table or bullet list summarizing the details of each recommendation. | X |  |  |  |  |  |  |  |  |  |  |  |  | 12
Comments
Demonstration |  | Demo Video | Video uploaded into the proper location(s) | x |  |  |  |  |  |  |  |  |  |  |  |  | 12 | 2 | 24
Comments |  |  |  |  |  |  |  |  |  |  |  |  |  |  |  |  | Total Points |  | 96
 |  |  |  |  |  |  |  |  |  |  |  |  |  |  |  |  | Points Available |  | 96
 |  |  |  |  |  |  |  |  |  |  |  |  |  |  |  |  | Grade % |  | 100%

Sheet: G6R
Gate 6 Technical Report Rubric
Category | Report Sec. # | Title | Requirements (Additional information provided in Guidelines_Report.doc) | Meets Expectations (12) | (11) | (10) | (9) | (8) | (7) | (6) | (5) | (4) | (3) | (2) | (1) | No Evidence (0) | Score (0-12) | Weight | Avg. Score
Updated Sections based on feedback from Previous Gate(s) | ii | Executive Summary | Updated for Gate 6 and based upon feedback from previous Gate Report. | x |  |  |  |  |  |  |  |  |  |  |  |  | 12 | 1 | 12
 | 8.3 | As Built / Implemented Documentation |  | x |  |  |  |  |  |  |  |  |  |  |  |  | 12
 | 10.3 | MS Teams File Documentation |  | x |  |  |  |  |  |  |  |  |  |  |  |  | 12
Technical Documentation | 6.1 | Mechanical Design | Provides a mechanical description for the project design with sufficient detail for fabrication/manufacturing/assembly. The descriptions include tolerances, part numbering, and material specifications. Provides a manufacturing plan for each part. | x |  |  |  |  |  |  |  |  |  |  |  |  | 12 | 1 | 12
 | 6.2 | Electrical Design | Provides an electrical description for the project design with sufficient detail for fabrication/manufacturing/assembly. Provides complete circuit diagrams. Evaluates the results of circuit breadboards. Provides complete wiring diagrams including cables and connectors. Provides a PC board layout ready for production including mounting points. | x |  |  |  |  |  |  |  |  |  |  |  |  | 12
 | 6.3 | Software & Programming | Provides a description of the software for the project with sufficient detail for reproducibility and troubleshooting. Includes complete flow diagrams including links and operating interfaces. | x |  |  |  |  |  |  |  |  |  |  |  |  | 12
 | 6.4 | Technical Data Sheets | Introduce the equipment and purpose of use, and reference data sheet in Appendix. | x |  |  |  |  |  |  |  |  |  |  |  |  | 12
Test and Evaluation | 9.1 | Test Plan & Testing Phase | Well defined test plan appropriate to the expected level of testing. Testing requirements and test sequences developed and data recording methods identified. All test equipment and sensor needs have been identified and ordered. Clearly defined plan in place for the type of data analysis method(s) to be used. Test location Identified and outside resources identified and ready to support testing as needed. | x |  |  |  |  |  |  |  |  |  |  |  |  | 12 | 1 | 12
 | 9.2 | Test Results and Data Analysis | Captured test data properly documented and organized. Analysis of test data clearly justifies the final conclusions of the test efforts. | x |  |  |  |  |  |  |  |  |  |  |  |  | 12
 | 9.3 | Corrective Action Plan (if needed) | If a product performance deficiency is found during test data analysis, create a detailed Corrective Action Plan that describes each deficiency found and how it will impact meeting the client requirements, deliverables, and your project schedule. This action plan should be thoroughly reviewed and approved by the client. | x |  |  |  |  |  |  |  |  |  |  |  |  | 12
Project Management | 10.1 | Project Schedule | Task descriptions contain an acceptable level of detail. Task predecessor links properly used with no open-ended tasks. Task progress bar properly used to indicate % completion status of active tasks. All tasks set to Auto-Schedule mode. All Resource Names added. Milestones identified and properly linked. All task flow in a chronological order. | x |  |  |  |  |  |  |  |  |  |  |  |  | 12 | 1 | 12
 | 10.2 | Gantt Charts & Critical Path | Gantt Chart(s): Properly formatted to clearly define project status details and all information in the Gantt Charts is aligned with the Gate requirements. Task level information clearly indicates an appropriate level of detail. Chart types are properly created as defined in the Project Schedule Guidelines. Critical Path: MS Project able to calculate critical path based on existing tasks and predecessor structure. Clearly defined and shown using the Level 3 chart format. Gantt Charts content should be To gate Level 2 from Gate 1 through Gate 6 | x |  |  |  |  |  |  |  |  |  |  |  |  | 12
Project Summary | 11.1 | Project Results | RE-visit Problem Statement and describe team efforts to resolve primary issues, results of build and testing efforts, critical techniques used, and critical data results and analysis conclusions | x |  |  |  |  |  |  |  |  |  |  |  |  | 12 | 1 | 12
 | 11.2 | Lessons Learned | List most important lessons learned by sharing experiences of how new and improved techniques or processes were developed and how they were instrumental in achieving your design requirements. | X |  |  |  |  |  |  |  |  |  |  |  |  | 12
 | 11.3 | Recommendations | Describe all team recommendations with enough detail to best direct your client to initiate future action within their company. Create a table or bullet list summarizing the details of each recommendation. | x |  |  |  |  |  |  |  |  |  |  |  |  | 12
 | NA | Project overall results | Has the final product been tested and proven to meet every requirement as outlined in the requirements matrix? | X |  |  |  |  |  |  |  |  |  |  |  |  | 12 | 1 | 12
Report Quality |  | Formatting and References | Uses IEEE format to develop the Title Page, Table of Contents, Appendix, and Work Cited sections of this report. | x |  |  |  |  |  |  |  |  |  |  |  |  | 12 | 1 | 12
 |  | Text | Free of spelling and grammatical errors, text flows with contiguous threads, consistent format, use of 3rd person perspective, non-repeating ideas or information. | x |  |  |  |  |  |  |  |  |  |  |  |  | 12
 |  | Visual Aids | Visual aids (all figures including hand sketches, photos, charts, etc. and tables) are clear and readable and of professional quality. Graphic aspects labeled and linked to text to transmit critical information, units/scaling clear. Proper IEEE style utilized. | x |  |  |  |  |  |  |  |  |  |  |  |  | 12
 | A5 | Mechanical Drawings | Provides a full engineering mechanical description and documentation for the project design in sufficient detail that the design could be manufactured/produced/assembled. | x |  |  |  |  |  |  |  |  |  |  |  |  | 12 | 1 | 12
 | A6 | Electrical Drawings | Provides a full engineering electrical description and documentation for the project design in sufficient detail that the design could be manufactured/produced/assembled. | x |  |  |  |  |  |  |  |  |  |  |  |  | 12
 | A7 | Software and Programming Files | Provides a full engineering software description and documentation for the project design in sufficient detail that the program can be reproduced. | x |  |  |  |  |  |  |  |  |  |  |  |  | 12
 | A9 | Failure Modes and Effects Analysis (FMEA) | Attach the FMEA in the Appendix | x |  |  |  |  |  |  |  |  |  |  |  |  | 12
 | A10 | Parts Requisition Forms | Contains copies of all parts requisition form submitted
 | A11 | Team Member Contact Information | Create a bullet list or table of all the team members contact information. Include name, professional contact information, and an email address that will be valid after the class is complete. | x |  |  |  |  |  |  |  |  |  |  |  |  | 12
Comments |  |  |  |  |  |  |  |  |  |  |  |  |  |  |  |  | Total Points |  | 96
 |  |  |  |  |  |  |  |  |  |  |  |  |  |  |  |  | Points Available |  | 96
 |  |  |  |  |  |  |  |  |  |  |  |  |  |  |  |  | Grade % |  | 100%

Sheet: Data
Section | Title | Text
i | Cover Page and Table of Contents | Professional representation of the project. Gate Report sections listed (e.g., body, references, and appendices) with correct page numbers. Updated and/or impacted sections highlighted in red.
ii | Executive Summary | Concise summary of the current accomplishments and the future expectations for the next Gate Report. Updated at every Gate Report.
 | Formatting and References | Uses IEEE format to develop the Title Page, Table of Contents, Appendix, and Work Cited sections of this report.
 | Text | Free of spelling and grammatical errors, text flows with contiguous threads, consistent format, use of 3rd person perspective, non-repeating ideas or information.
 | Visual Aids | Visual aids (all figures including hand sketches, photos, charts, etc. and tables) are clear and readable and of professional quality. Graphic aspects labeled and linked to text to transmit critical information, units/scaling clear. Proper IEEE style utilized.
 | Introduction | Presentation Title (closely matches project name), Outline (follows Rubric), Team Members (photo, name, academic major, team role) Concise overview of project.
 | Oral Presentation Skill | Clear enunciation when discussing engineering design. All members are participating. Smooth transitions between topics and presenters.
 | Audio / Visual Quality of Presentation | Figures and tables in engineering format, free of spelling and grammatical errors, data presented is well-organized and defined in tabular or graphical form. Annotations are used to describe key points of photos and graphics. All slides are labeled with page numbers and consistent formatting between slides. Audio quality good no background noise or distractions.
 | References | References (in-text and bibliography) properly cited in IEEE style. Proper use of the Zotero citation management tool
 | Demo Video | Video uploaded into the proper location(s)
 | Update Gate Report | Update Gate Report based upon feedback from previous Gate.
 | Comparison of results | Compare your experimental results to the theory. Describe the mathematical model(s) used to predict product performance (e.g., FEA, Electrical simulations, Mechanical analysis). Describe the experiments and measurements that support the design methodology.
 | Design suggestions | Describe the lessons learned during your project. Offer insight on potential areas for improvement and/or future work that can be dedicated to this project.
 | Participation | All team members are required to attend and participate in the Tech Expo.
 | Poster and Demo Materials | All demonstration materials are prepared and organized professionally. Poster outline, figures, and tables in engineering format, free of spelling and grammatical errors, data is well-organized and defined in tabular or graphical form. Annotations are used to describe key points in the figures.
 | Online Presence | Each team has created an online Microsoft Team meeting for online visitors to attend the Tech Expo. At least one team member is attentive online.
 | Design Evolution | Presents the evolution of your design by illustrating the developments made throughout the exploratory/conceptual/down-selection design phases. Points out the strengths and weaknesses of each design. Provides evidence to validate the concept selection.
1.1 | Problem Description | Includes context to the problem, reason for the problem, need for this project, defines who is impacted by the problem (customer / market) and how.
1.2 | Problem Statement | Describes the problem in technical detail and Quantifies the impact on the customer/market. Introduce critical performance metrics. Defines the end-user population (e.g., person, environment, or organization).
1.3 | Scope of Work | Describes the approach to solve this problem, the projected timeline plan, and the assumptions, limitations, and constraints of the project. Describes the services and/or materials to be obtained from the client.
1.4 | Deliverables | Defines the final product to be delivered at the end of the project. Defines milestones that progress toward the completion of the final product. Deliverables include a completed prototype, all spare parts, design and technical documentation, and test results. The information is specific to the project, and not described as general project deliverables.
2.1 | Review of the Problem Area | Summarizes and synthesizes existing research to support the claims of the problem. Information gathered is technically sound and adequate, e.g., summarizes benchmarked prototypes, patents, research publications, etc. Properly cited work using IEEE style. Includes visual aids (e.g., figures, tables) and technical details to introduce the various claims and approaches published in literature.
2.2 | Review of State-of-the-Art | Introduces relevant products and technologies that exist in research or the market. Introduces appropriate metrics to describe the State-of-Art performance.
3.1 | Requirements Matrix | Translates the client's needs into engineering statements using relevant metrics of performance (one, unambiguous and measurable value). Describes the relationships between these statements. Has received Client approval.
3.2 | Exploratory Concepts | Presents (at least) three exploratory designs that can potentially meet the design requirements. Provides evidence to substantiate the validity of the designs. Points out the strengths and weaknesses of each design. Includes sketches and/or models to demonstrate the completeness of the exploratory designs.
3.3 | Resource Requirements | Expected resource needs to support the project are clearly defined. Status and timeline of any on-going Investigations into resource availabilities is well defined.
4.1 | Member Bios, Team Member Roles | Table includes students' image, name, degree(s), and assigned role(s).
4.2 | Team Charter | Expectations listed for each team member, faculty mentor and customer mentor.
5.1 | System Decomposition | Decompose the complexity of the system/problem by describing its constituent components. Break down the complex system/problem into smaller, more manageable parts by building a hierarchical representation of critical subsystems. Depending on the system, you may consider developing a functional decomposition, assembly decomposition, or service-based decomposition.
5.2 | Conceptual Design | Presents (at least) three detailed conceptual designs that can meet the design requirements. Provides evidence to substantiate the validity of the designs. Points out strengths and weaknesses of each. Includes sketches and/or models to demonstrate the completeness of the designs.
5.3 | Down Selection Process | Discusses the results of the Down Selection process, includes the criteria and weighting factors for each criterion. Defines the final selection and explains why.
5.4 | Final Design Description | Describes all aspects of the final design and how it meets the client's requirements.
5.5 | Design Calculations & Analysis Results | Provide and describe the analytical models used to support the design. (FEA, Electrical simulations, Mechanical analysis) Provide and describe the experiments and measurements that support the design.
5.6 | Mathematical Modeling (Lit review) | Define all analytical approaches to be used to support confirmation that your system design will meet the client requirements.
5.7 | Critical Issues & Risk Mitigation | Explains critical issues that have arisen. Translates critical issues into sequential action items. Explains the affect(s) on the critical path and schedule.
6.1 | Mechanical Design | Provides a mechanical description for the project design with sufficient detail for fabrication/manufacturing/assembly. The descriptions include tolerances, part numbering, and material specifications. Provides a manufacturing plan for each part.
6.2 | Electrical Design | Provides an electrical description for the project design with sufficient detail for fabrication/manufacturing/assembly. Provides complete circuit diagrams. Evaluates the results of circuit breadboards. Provides complete wiring diagrams including cables and connectors. Provides a PC board layout ready for production including mounting points.
6.3 | Software & Programming | Provides a description of the software for the project with sufficient detail for reproducibility and troubleshooting. Includes complete flow diagrams including links and operating interfaces.
6.4 | Technical Data Sheets | Introduce the equipment and purpose of use, and reference data sheet in Appendix.
6.5 | System Design Bill of Materials (BOM) | Provide a completed Design Bill of Materials table that defines each system grouping with its associated assemblies and individual parts fully defined. Each line item in the table has an identifiable part numbering system created by the team.
7.1 | Failure Modes and Effects Analysis (FMEA) | Provide a Failure Modes and Effects Analysis (FMEA) with discussion of results. Components used for the device should be included. Tooling test equipment should not be included. style. Include the appropriate level of visual aids (e.g., figures, tables) and technical detail to clearly define the various approaches researched.
8.1 | Parts Requisition | Parts ordering needs clearly defined. Parts Requisition Form filled in correctly and submitted. Summary table clearly defines all parts ordered. Parts delivery dates clearly defined. Copies of all forms submitted have been placed in Appendix A9.
8.2 | Fabrication Plan | Fabrication plan clearly defined. All special assembly or testing needs are described. Alternate build techniques and materials identified for costly or long lead-time components. Inspection plan clearly defined for all fabricated or purchased components.
8.3 | As Built / Implemented Documentation | Describe the differences between the 'as built' design vs. the intended design features. Provide sketches and/or CAD models as visual aids to support your description of the design differences. Explain how the as built prototype features may impact capturing data during the testing phase. Define any test plan modifications needed to capture your data.
8.4 | Established Project Budget | Describe the amount of funds that will be available to procure all necessary parts and materials to build your prototype.
8.5 | Prototype Parts Expense | Tabulate the total expenses for the various systems of your project, such as, ‘Mechanical Parts’, ‘Electrical Components’, ‘Supplies’, ‘Electrical Suppliers’, ‘Special Tools”, etc.
8.6 | Budget Summary | Provide a summary of the status of all expenses and available budget amounts.
9.1 | Test Plan & Testing Phase | Well defined test plan appropriate to the expected level of testing. Testing requirements and test sequences developed and data recording methods identified. All test equipment and sensor needs have been identified and ordered. Clearly defined plan in place for the type of data analysis method(s) to be used. Test location Identified and outside resources identified and ready to support testing as needed.
9.2 | Test Results and Data Analysis | Captured test data properly documented and organized. Analysis of test data clearly justifies the final conclusions of the test efforts.
9.3 | Corrective Action Plan (if needed) | If a product performance deficiency is found during test data analysis, create a detailed Corrective Action Plan that describes each deficiency found and how it will impact meeting the client requirements, deliverables, and your project schedule. This action plan should be thoroughly reviewed and approved by the client.
10.1 | Project Schedule | Task descriptions contain an acceptable level of detail. Task predecessor links properly used with no open-ended tasks. Task progress bar properly used to indicate % completion status of active tasks. All tasks set to Auto-Schedule mode. All Resource Names added. Milestones identified and properly linked. All task flow in a chronological order.
10.2 | Gantt Charts & Critical Path | Gantt Chart(s): Properly formatted to clearly define project status details and all information in the Gantt Charts is aligned with the Gate requirements. Task level information clearly indicates an appropriate level of detail. Chart types are properly created as defined in the Project Schedule Guidelines. Critical Path: MS Project able to calculate critical path based on existing tasks and predecessor structure. Clearly defined and shown using the Level 3 chart format. Gantt Charts content should be To gate
10.3 | MS Teams File Documentation | Certification table filled in and signed by the responsible team member.
11.1 | Project Results | RE-visit Problem Statement and describe team efforts to resolve primary issues, results of build and testing efforts, critical techniques used, and critical data results and analysis conclusions | Team Meeting Notes
11.2 | Lessons Learned | List most important lessons learned by sharing experiences of how new and improved techniques or processes were developed and how they were instrumental in achieving your design requirements.
11.3 | Recommendations | Describe all team recommendations with enough detail to best direct your client to initiate future action within their company. Create a table or bullet list summarizing the details of each recommendation.
NA | Project overall results | Has the final product been tested and proven to meet every requirement as outlined in the requirements matrix?
A1 | Communication Plan | Communication Plan template fully filled in. Communication channels appear appropriate for the current team progress and level of communication occurring. Clearly defined descriptions of all portions of the plan.
A2 | Team Member Bios | Describes each member's motivation to participate and succeed in this project.
A3 | Down Selection Process | Copy of calculation results for each down selection analysis completed.
A4 | Team Meeting Notes | Contains invitees, attendees, agenda, meeting notes, and task assignment with team member responsibilities clearly labeled.
A5 | Mechanical Drawings | Provides a full engineering mechanical description and documentation for the project design in sufficient detail that the design could be manufactured/produced/assembled.
A6 | Electrical Drawings | Provides a full engineering electrical description and documentation for the project design in sufficient detail that the design could be manufactured/produced/assembled.
A7 | Software and Programming Files | Provides a full engineering software description and documentation for the project design in sufficient detail that the program can be reproduced.
A8 | Technical Data Sheets | All manufacturers' data sheets attached.
A9 | Failure Modes and Effects Analysis (FMEA) | Attach the FMEA in the Appendix
A10 | Parts Requisition Forms | Contains copies of all parts requisition form submitted
A11 | Team Member Contact Information | Create a bullet list or table of all the team members contact information. Include name, professional contact information, and an email address that will be valid after the class is complete.
