JDanison/ENGT-480---Senior-Capstone/!Project Files/Software/Receiver Firmware/excel-results/Configuration 1.xlsx

Sheet: Summary
Test Conditions Label | Configuration 1
General Notes | Generated At: 2026-02-23 20:21:44
Filtered AVV line? | Yes | AVV capacitor values | 10ohm, 0.1uF, 10nF
Filtered ADC line? | Yes | ADC capacitor values | 4.5nF for A+ and A-
Filtered A+ and A- wires? | No
Continuous Monitoring Summary
ADC Variation & Extremes
Raw ADC High | Raw ADC Low | Avg ADC Variation
6780795 | 6765381 | 4986.928571
Strain Variation & Extremes
Strain High (uE) | Strain Low (uE) | Avg Variation Strain Step (uE)
27.75 | -15.32 | 10.45392857
Sample Time Variation & Extremes
Sample Time High (ms) | Sample Time Low (ms) | Avg Sample Time (ms) |  | Total Samples | 29
2003 | 1971 | 2000.827586 |  | Total Time (s) | 60.83
Timing details are available on the Timing tab.
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
