JDanison/ENGT-480---Senior-Capstone/!Project Files/Software/Receiver Firmware/excel-results/Configuration 2.xlsx

Sheet: Summary
Test Conditions Label | Configuration 2
General Notes | Generated At: 2026-02-23 20:30:46
Filtered AVV line? | No | AVV capacitor values | N/A
Filtered ADC line? | Yes | ADC capacitor values | 4.5nF on A+ and A-
Filtered A+ and A- wires?
Continuous Monitoring Summary
ADC Variation & Extremes
Raw ADC High | Raw ADC Low | Avg ADC Variation
6714064 | 6684470 | 10297.92857
Strain Variation & Extremes
Strain High (uE) | Strain Low (uE) | Avg Variation Strain Step (uE)
42.74 | -17.64 | 20.73857143
Sample Time Variation & Extremes
Sample Time High (ms) | Sample Time Low (ms) | Avg Sample Time (ms) |  | Total Samples | 29
2003 | 1972 | 2001.241379 |  | Total Time (s) | 60.84
Timing details are available on the Timing tab.
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
