JDanison/ENGT-480---Senior-Capstone/!Project Files/Software/Receiver Firmware/excel-results/Configuration 3.xlsx

Sheet: Summary
Test Conditions Label | Configuration 3
General Notes | Generated At: 2026-02-23 20:33:31
Filtered AVV line? | No | AVV capacitor values | N/A
Filtered ADC line? | No | ADC capacitor values | N/A
Filtered A+ and A- wires? | No
Continuous Monitoring Summary
ADC Variation & Extremes
Raw ADC High | Raw ADC Low | Avg ADC Variation
6480090 | 6361357 | 23330.5
Strain Variation & Extremes
Strain High (uE) | Strain Low (uE) | Avg Variation Strain Step (uE)
603.72 | -586.14 | 166.0164286
Sample Time Variation & Extremes
Sample Time High (ms) | Sample Time Low (ms) | Avg Sample Time (ms) |  | Total Samples | 29
2003 | 1972 | 2001 |  | Total Time (s) | 60.83
Timing details are available on the Timing tab.
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
