JDanison/ENGT-480---Senior-Capstone/!Project Files/Software/Receiver Firmware/excel-results/Configuration 4.xlsx

Sheet: Summary
Test Conditions Label | Configuration 4
General Notes | Generated At: 2026-02-23 20:36:46
Filtered AVV line? | No | AVV capacitor values | N/A
Filtered ADC line? | Yes | ADC capacitor values | 1nF for A+ and A-
Filtered A+ and A- wires? | No
Continuous Monitoring Summary
ADC Variation & Extremes
Raw ADC High | Raw ADC Low | Avg ADC Variation
6943218 | 6916810 | 9242.857143
Strain Variation & Extremes
Strain High (uE) | Strain Low (uE) | Avg Variation Strain Step (uE)
40.54 | -55.07 | 22.60678571
Sample Time Variation & Extremes
Sample Time High (ms) | Sample Time Low (ms) | Avg Sample Time (ms) |  | Total Samples | 29
2003 | 1973 | 2000.896552 |  | Total Time (s) | 60.83
Timing details are available on the Timing tab.
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
