JDanison/ENGT-480---Senior-Capstone/!Project Files/Software/Receiver Firmware/excel-results/Configuration 5.xlsx

Sheet: Summary
Test Conditions Label | Configuration 5
General Notes | Generated At: 2026-02-23 20:40:32
Filtered AVV line? | Yes | AVV capacitor values | 10 ohm, 0.1uF, 10nF
Filtered ADC line? | Yes | ADC capacitor values | 1nF for A+ and A-
Filtered A+ and A- wires? | No
Continuous Monitoring Summary
ADC Variation & Extremes
Raw ADC High | Raw ADC Low | Avg ADC Variation
6942999 | 6907595 | 7802.071429
Strain Variation & Extremes
Strain High (uE) | Strain Low (uE) | Avg Variation Strain Step (uE)
45.12 | -21.43 | 22.01535714
Sample Time Variation & Extremes
Sample Time High (ms) | Sample Time Low (ms) | Avg Sample Time (ms) |  | Total Samples | 29
2003 | 1971 | 2001.448276 |  | Total Time (s) | 60.84
Timing details are available on the Timing tab.
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
