JDanison/ENGT-480---Senior-Capstone/!Project Files/Software/Lab Tests/Brass Exstensometer Results.xlsm

Results Table 1
 | YIELD LOAD | MAXIMUM LOAD | Yield Stress | UTS | % Elongation at Break | Modulus of Elasticity (Young's Modulus) | % Elongation at Yield | Displacement at Break (Standard) | Tensile Strength at Break | Nominal Strain at Break
 | (kgf) | (kgf) | (kgf/mm^2) | (kgf/mm^2) | (%) | (kgf/mm^2) | (%) | (mm) | (kgf/mm^2) | (%)
2 | 618.52 | 735.01 | 30.37 | 36.1 | 3.99 | 12000 | 0.44 | 5.11 | 36.1 | 1.73
Results Table 2
 | Tensile Strength | Tensile Strength at Break | % Elongation at Break (Strain 1) | Modulus (Linear Region) | Modulus (Secant 1 %) | Width | Thickness
 | (kgf/mm^2) | (kgf/mm^2) | (%) | (kgf/mm^2) | (kgf/mm^2) | (mm) | (mm)
2 | 36.1 | 36.095 | 3.99 | 12000 | 3280 | 12.725 | 1.6
Time measurement | Extension | Strain 1 | Primary load measurement
(s) | (mm) | (%) | (kgf)
0 | 0.0183 | 3e-05 | 22.80213
0.01 | 0.01837 | -4e-05 | 22.7972
0.02 | 0.01861 | -1e-05 | 22.81592
0.03 | 0.01894 | 4e-05 | 22.88221
0.04 | 0.0195 | 2e-05 | 23.04242
0.05 | 0.02015 | 0.00024 | 23.36611
0.06 | 0.02098 | 0.00048 | 23.90196
0.07 | 0.02209 | 0.00075 | 24.68416
0.08 | 0.02334 | 0.00129 | 25.75022
0.09 | 0.02452 | 0.00183 | 27.07372
0.1 | 0.02563 | 0.00245 | 28.53094
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
