JDanison/ENGT-480---Senior-Capstone/!Project Files/Software/Lab Tests/System Lab Test Results.xlsx

Sheet: Formatted
Time (s) | Raw ADC | Zeroed ADC | Raw Strain | ABS Strain
0.79 | 6946199 | -1217 | -9.07 | 9.07
0.84 | 6949360 | 1944 | 14.48 | 14.48
0.89 | 6946241 | -1175 | -8.75 | 8.75
0.95 | 6938644 | -8772 | -65.36 | 65.36
1 | 6946067 | -1349 | -10.05 | 10.05
1.05 | 6946902 | -514 | -3.83 | 3.83
1.11 | 6945311 | -2105 | -15.68 | 15.68
1.16 | 6951166 | 3750 | 27.94 | 27.94
1.21 | 6950957 | 3541 | 26.38 | 26.38
1.26 | 6947660 | 244 | 1.82 | 1.82
1.32 | 6951857 | 4441 | 33.09 | 33.09
1.37 | 6951256 | 3840 | 28.61 | 28.61
1.57 | 6946593 | -823 | -6.13 | 6.13
1.63 | 6917710 | -29706 | -221.33 | 221.33
1.68 | 6917695 | -29721 | -221.44 | 221.44
1.73 | 6918174 | -29242 | -217.87 | 217.87
1.79 | 6918193 | -29223 | -217.73 | 217.73
1.84 | 6922530 | -24886 | -185.42 | 185.42
1.89 | 6925227 | -22189 | -165.32 | 165.32
1.95 | 6925916 | -21500 | -160.19 | 160.19
2 | 6926153 | -21263 | -158.42 | 158.42
2.05 | 6926144 | -21272 | -158.49 | 158.49
2.1 | 6922277 | -25139 | -187.3 | 187.3
2.16 | 6914726 | -32690 | -243.56 | 243.56
2.21 | 6923995 | -23421 | -174.5 | 174.5
2.26 | 6924530 | -22886 | -170.51 | 170.51
2.32 | 6920407 | -27009 | -201.23 | 201.23
2.37 | 6923894 | -23522 | -175.25 | 175.25
2.42 | 6916801 | -30615 | -228.1 | 228.1
2.62 | 6914792 | -32624 | -243.07 | 243.07
2.68 | 6923895 | -23521 | -175.25 | 175.25
2.73 | 6918272 | -29144 | -217.14 | 217.14
2.78 | 6917417 | -29999 | -223.51 | 223.51
2.84 | 6917634 | -29782 | -221.89 | 221.89
2.89 | 6921579 | -25837 | -192.5 | 192.5
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
64.05 | -5454044 | -12401460 | -92398.08 | 92398.08
64.1 | -5434397 | -12381813 | -92251.7 | 92251.7
64.16 | -5429620 | -12377036 | -92216.11 | 92216.11
64.21 | -5427931 | -12375347 | -92203.52 | 92203.52
64.26 | -5422638 | -12370054 | -92164.09 | 92164.09

Sheet: Raw Data
0.79, 6946199, -1217, -9.07
0.84, 6949360, 1944, 14.48
0.89, 6946241, -1175, -8.75
0.95, 6938644, -8772, -65.36
1.00, 6946067, -1349, -10.05
1.05, 6946902, -514, -3.83
1.11, 6945311, -2105, -15.68
1.16, 6951166, 3750, 27.94
1.21, 6950957, 3541, 26.38
1.26, 6947660, 244, 1.82
1.32, 6951857, 4441, 33.09
1.37, 6951256, 3840, 28.61
1.57, 6946593, -823, -6.13
1.63, 6917710, -29706, -221.33
1.68, 6917695, -29721, -221.44
1.73, 6918174, -29242, -217.87
1.79, 6918193, -29223, -217.73
1.84, 6922530, -24886, -185.42
1.89, 6925227, -22189, -165.32
1.95, 6925916, -21500, -160.19
2.00, 6926153, -21263, -158.42
2.05, 6926144, -21272, -158.49
2.10, 6922277, -25139, -187.30
2.16, 6914726, -32690, -243.56
2.21, 6923995, -23421, -174.50
2.26, 6924530, -22886, -170.51
2.32, 6920407, -27009, -201.23
2.37, 6923894, -23522, -175.25
2.42, 6916801, -30615, -228.10
2.62, 6914792, -32624, -243.07
2.68, 6923895, -23521, -175.25
2.73, 6918272, -29144, -217.14
2.78, 6917417, -29999, -223.51
2.84, 6917634, -29782, -221.89
2.89, 6921579, -25837, -192.50
2.94, 6921036, -26380, -196.55
3.00, 6923073, -24343, -181.37
3.05, 6923064, -24352, -181.44
3.10, 6917797, -29619, -220.68
3.15, 6920412, -27004, -201.20
3.21, 6926137, -21279, -158.54
3.26, 6924464, -22952, -171.01
3.31, 6916547, -30869, -229.99
3.37, 6906080, -41336, -307.98
3.42, 6905041, -42375, -315.72
3.47, 6916022, -31394, -233.90
3.68, 6909215, -38201, -284.62
3.73, 6921920, -25496, -189.96
3.78, 6922257, -25159, -187.45
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
62.68, -5767305, -12714721, -94732.05
62.74, -5743532, -12690948, -94554.93
62.79, -5721215, -12668631, -94388.65
62.84, -5701344, -12648760, -94240.61
62.89, -5687619, -12635035, -94138.34
62.95, -5681438, -12628854, -94092.30
63.00, -5668187, -12615603, -93993.57
63.05, -5640448, -12587864, -93786.90
63.11, -5629065, -12576481, -93702.09
63.16, -5622344, -12569760, -93652.01
63.21, -5612377, -12559793, -93577.75
63.26, -5600242, -12547658, -93487.34
63.47, -5592955, -12540371, -93433.05
63.52, -5535700, -12483116, -93006.47
63.57, -5531395, -12478811, -92974.39
63.63, -5516000, -12463416, -92859.69
63.68, -5498359, -12445775, -92728.25
63.73, -5496636, -12444052, -92715.41
63.79, -5492595, -12440011, -92685.30
63.84, -5488276, -12435692, -92653.12
63.89, -5473067, -12420483, -92539.81
63.94, -5460430, -12407846, -92445.66
64.00, -5460271, -12407687, -92444.47
64.05, -5454044, -12401460, -92398.08
64.10, -5434397, -12381813, -92251.70
64.16, -5429620, -12377036, -92216.11
64.21, -5427931, -12375347, -92203.52
64.26, -5422638, -12370054, -92164.09
---------------------------------------
Monitoring stopped. Collected 1038 samples.
Saving to SD card...
Data saved to: /lab-testing/strain-log4.txt
[LOG_END]
===========================
