JDanison/ENGT-480---Senior-Capstone/GR04 TODO Notes.txt

Put Some Sample Data In
	- A couple event packets
	
Don't need to design the PCB, but talk about holding points, prcoess of what I am planning on doing, and a timeline to go along with it.
