JDanison/ENGT-480---Senior-Capstone/!Project Files/Hardware/TODO.txt

PCB:
Power Conversion Page:
Find a Ring Lug Terminal for PCB
