JDanison/ENGT-480---Senior-Capstone/(list of files, drawings)

Other design files:
!Project Files/Hardware/Altium/Wabash Capstone Project/PowerConversion.SchDoc
!Project Files/Hardware/Altium/Wabash Capstone Project/Wabash Capstone Project.PrjPcb
!Project Files/Hardware/Final Schematic v1.fzz
!Project Files/Hardware/Noise Filter Circuit.fzz
!Project Files/Hardware/ROUGH Schematic v1.fzz
