JDanison/ENGT-480---Senior-Capstone/(commit log)

2025-12-06 New Directory but working I2C sensors.
    Next steps:
    Format SD card to FAT32
    Try the current code state.
2025-12-09 Updated Code
    1) Got SD Card File Storage Working
    2) Updated Code to allow for sensors to trigger event thresholds
    3) Updated Logic to when event is triggered, record 20 cycles of sensors readings for the accelerometer
    4) Once event is over, log to SD Card
    5) Added menu options in the terminal for demo control
2026-01-16 Updated Comments w/ Correct Authors
    [2025_Rubric_Gates 1-6 (1).xlsx]
2026-01-16 Added ADC Module & Sample Strain Gauge Code
    Next Step:
    Attach the strain gauge to the spare metal / cardboard / something so that I can test the system functionality.
2026-01-20 Create Danison - Spring 2026 - CW01 Badge Proof.JPG
2026-01-22 Updated Now working software & hardware
    Need to optimize this code a bit more and have less hard coded values and make them be global constants.
    Also need to reduce the amount of options to handle.
    Also need to figure out how to reduce the noise either via software (but like better than taking average of 10 samples) or via hardware with filters.
    [NAU7802_Module.cpp, NAU7802_Module.h, main.cpp]
2026-02-03 Made Gannt Chart & Fixed Heltec Spelling
    [GanttChartForPCB.xlsx]
2026-02-03 Updated Fritzing Schematic
    [ROUGH Schematic v1.fzz]
2026-02-10 Updated Files
    [PowerConversion.SchDoc]
2026-02-20 Added new Fritzing Files
    [Noise Filter Circuit.fzz]
2026-02-24 Added Excel Tracking
    [Configuration 1.xlsx, Configuration 2.xlsx, Configuration 3.xlsx, Configuration 4.xlsx, Configuration 5.xlsx]
2026-03-03 Working Event Capture
    Changed Event Capture:
    1) 2 Second Capture Interval
    2) Sample Accel and Strain 1 - 1
2026-03-20 Added Wireless Transmission & User Interface
2026-04-07 CLIP IT AND SHIP IT
    Updated Interface, Build Compiles to .exe, Wireless Transfer working once again.
2026-04-17 Project Notes, Main Window Updates, and Final Schematic Creation
    [Final Schematic v1.fzz]
2026-04-23 Added Calibration Back
2026-04-24 .exe launch no longer pops open powershell windows
    me when I lie abt being done.
